Eric-2012/ESP32-CAN/PCB/ESP32-CAN/Pictures/ESP32-CAN2.png

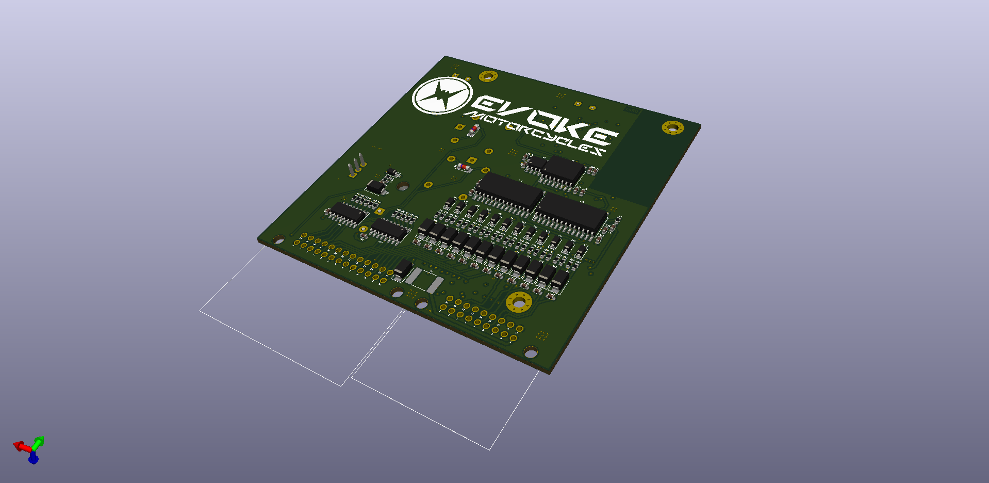
PCB/ESP32-CAN/Pictures/ESP32-CAN2.png
