Eric-2012/ESP32-CAN/PCB/ESP32-CAN/Pictures/ESP32-CAN - no bg.png

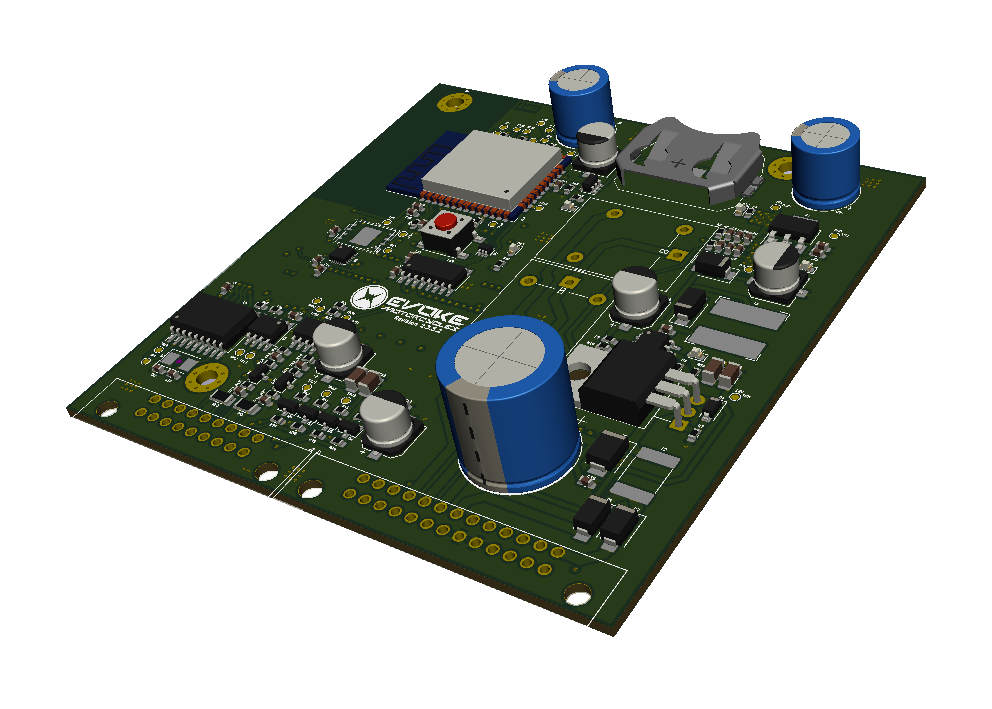
PCB/ESP32-CAN/Pictures/ESP32-CAN - no bg.png
