Eric-2012/ESP32-CAN/PCB/Production Files/Archived Nov 5, 2021/BOM ESP32-CAN Revision 3.3.3.xlsx

 | References | Value | Footprint | Quantity
1 | C5, C6, C64, C67, C68 | 100uF/25V | CP_Elec_6.3x5.8 | 5
2 | C54, C55 | 1500uf/16V | CP_Radial_D10.0mm_P5.00mm | 2
3 | C1 | 4700uF/25V | CP_Radial_D16.0mm_P7.50mm | 1
4 | C7, C9, C10, C15, C16, C17, C18, C19, C20, C21, C24, C25, C26, C27, C29, C30, C31, C34, C35, C36, C38, C39, C40, C43, C45, C46, C47, C48, C49, C50, C51, C52, C53, C58, C60, C61 | 100nF | C_0603_1608Metric | 36
5 | C8, C22, C23, C28, C32, C33, C44, C56, C57, C59, C62 | 10uF | C_0603_1608Metric | 11
6 | C13, C14, C41, C42 | 560pF | C_0603_1608Metric | 4
7 | C11, C12 | 22pF | C_0603_1608Metric | 2
8 | C4 | 10nF | C_0603_1608Metric | 1
9 | C2, C3 | 4.7uF | C_1206_3216Metric | 2
10 | C65, C66 | 10uf | C_1206_3216Metric | 2
11 | R4, R11, R24, R25, R26, R29, R47, R48, R49, R50, R51, R52, R53, R54, R55, R56, R57, R59, R73, R80, R81, R82, R83, R84, R85, R92 | 1.3kΩ | R_0603_1608Metric | 26
12 | R2, R8, R9, R18, R30, R38, R39, R41, R42, R43, R44, R45, R46, R60, R68, R71, R93 | 10KΩ | R_0603_1608Metric | 17
13 | R1, R22, R23, R28, R31, R58, R72, R74, R75, R76, R77, R78, R79 | 5.1KΩ | R_0603_1608Metric | 13
14 | R3, R12, R19, R37, R40 | 4.7KΩ | R_0603_1608Metric | 5
15 | R13, R14, R20, R21 | 100Ω | R_0603_1608Metric | 4
16 | R61, R65 | 3K3Ω | R_0603_1608Metric | 2
17 | R67, R70 | 22KΩ | R_0603_1608Metric | 2
18 | R5 | 68KΩ | R_0603_1608Metric | 1
19 | R6 | 12KΩ | R_0603_1608Metric | 1
20 | R7 | 100KΩ | R_0603_1608Metric | 1
21 | R10 | 3.24KΩ | R_0603_1608Metric | 1
22 | R66 | 220kΩ | R_0603_1608Metric | 1
23 | R62, R63 | 120Ω | R_1206_3216Metric | 2
24 | L1 | SRN1060-330M | L_Bourns-SRN1060 | 1
25 | D20, D21 | 1N4148 | D_MiniMELF_POLARITY | 2
26 | D9, D10, D11, D13, D14, D23, D31, D33, D34, D35, D36, D37, D38 | SMAJ20A | D_SMA_POL | 13
27 | D1, D2, D6, D8 | B240A | D_SMA_POL | 4
28 | D5 | B340A | D_SMA_POL | 1
29 | D3 | SMBJ20A | D_SMB | 1
30 | D12, D15, D16, D24, D32, D39, D40, D41, D42, D43, D44, D48, D49 | MM1Z3V0 | D_SOD-123_POLARITY | 13
31 | D4 | 9.1V | D_SOD-123_POLARITY | 1
32 | D17, D27, D28, D30, D46 | LED | LED_0603_1608Metric_POLARITY | 5
33 | D7, D22 | PESD1CAN | SOT-23 | 2
34 | U13 | ESP32-WROOM-32D | ESP32-WROOM-32 | 1
35 | U6 | MPU-9250 | QFN-24-1EP_3x3mm_P0.4mm_EP1.75x1.6mm | 1
36 | U9 | DS3231M | SOIC-16W_7.5x10.3mm_P1.27mm | 1
37 | U16, U17 | ULN2003 | SOIC-16_3.9x9.9mm_P1.27mm | 2
38 | U12 | CH340C | SOIC-16_3.9x9.9mm_P1.27mm | 1
39 | U4 | MCP2515-xSO | SOIC-18W_7.5x11.6mm_P1.27mm | 1
40 | U15, U18 | MCP23017_SO | SOIC-28W_7.5x17.9mm_P1.27mm | 2
41 | U5, U10 | TJA1050 | SOIC-8_3.9x4.9mm_P1.27mm | 2
42 | U3 | TPS5420D | SOIC-8_3.9x4.9mm_P1.27mm | 1
43 | U8 | MB85RC256V | SOIC-8_3.9x4.9mm_P1.27mm | 1
44 | U1 | LM1117M-3.3 | SOT-223-3_TabPin2 | 1
45 | Y1 | 8MHz | Crystal_SMD_5032-2Pin_5.0x3.2mm | 1
46 | F1, F2 | 0ZCF0100AF2A | Fuse_2920_7451Metric | 2
47 | SW1 | RESET | SW_SPST_PTS645 | 1
48 | BT1 | Battery_Cell | BatteryHolder_Keystone_3034_1x20mm | 1
49 |  |  | EvokeLogoName | 1
50 |  |  | EvokeLogoName3 | 1
51 | K1, K2 | G5LE-1 | Relay_SPDT_Omron-G5LE-1 | 2
52 | IC1 | W25M512JVEIQ | SON127P800X600X80-9N-D | 1
53 | Q2, Q3, Q4, Q5 | BSS138 | SOT-23 | 4
54 | IC2 | LTC4054 | SOT-23-5 | 1
55 | Q6 | UMH3N | SOT-363_SC-70-6 | 1
56 | Q1 | IRF9540N | TO-220-3_Horizontal_TabDown | 1
57 | J2 | 2x9_pin_Connector | 3118A0312 | 1
58 | J1 | 2x13_pin_Connector | 3126A0312 | 1
