Eric-2012/ESP32-CAN/PCB/ESP32-CAN.pdf

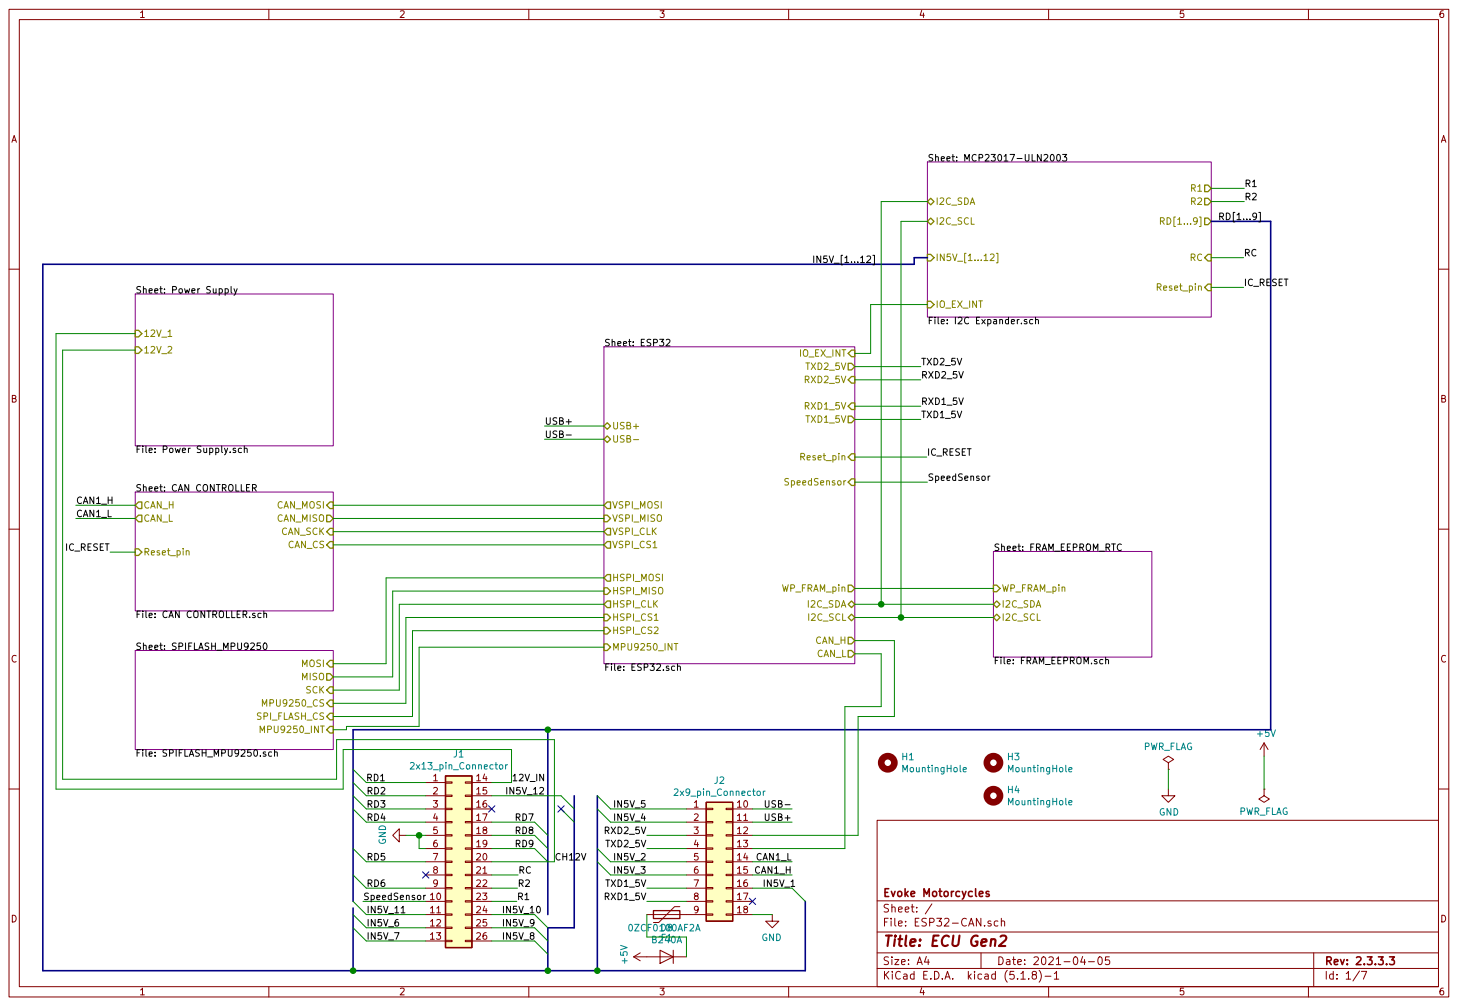
[picture p4: page 1]

Sheet: MCP23017-ULN2003 File: I2C Expander.sch

USB- USB+ USB- USB+ RD7

File: Power Supply.sch

File: ESP32-CAN.sch Sheet: / Evoke Motorcycles Sheet: CAN CONTROLLER
File: CAN CONTROLLER.sch CAN_H

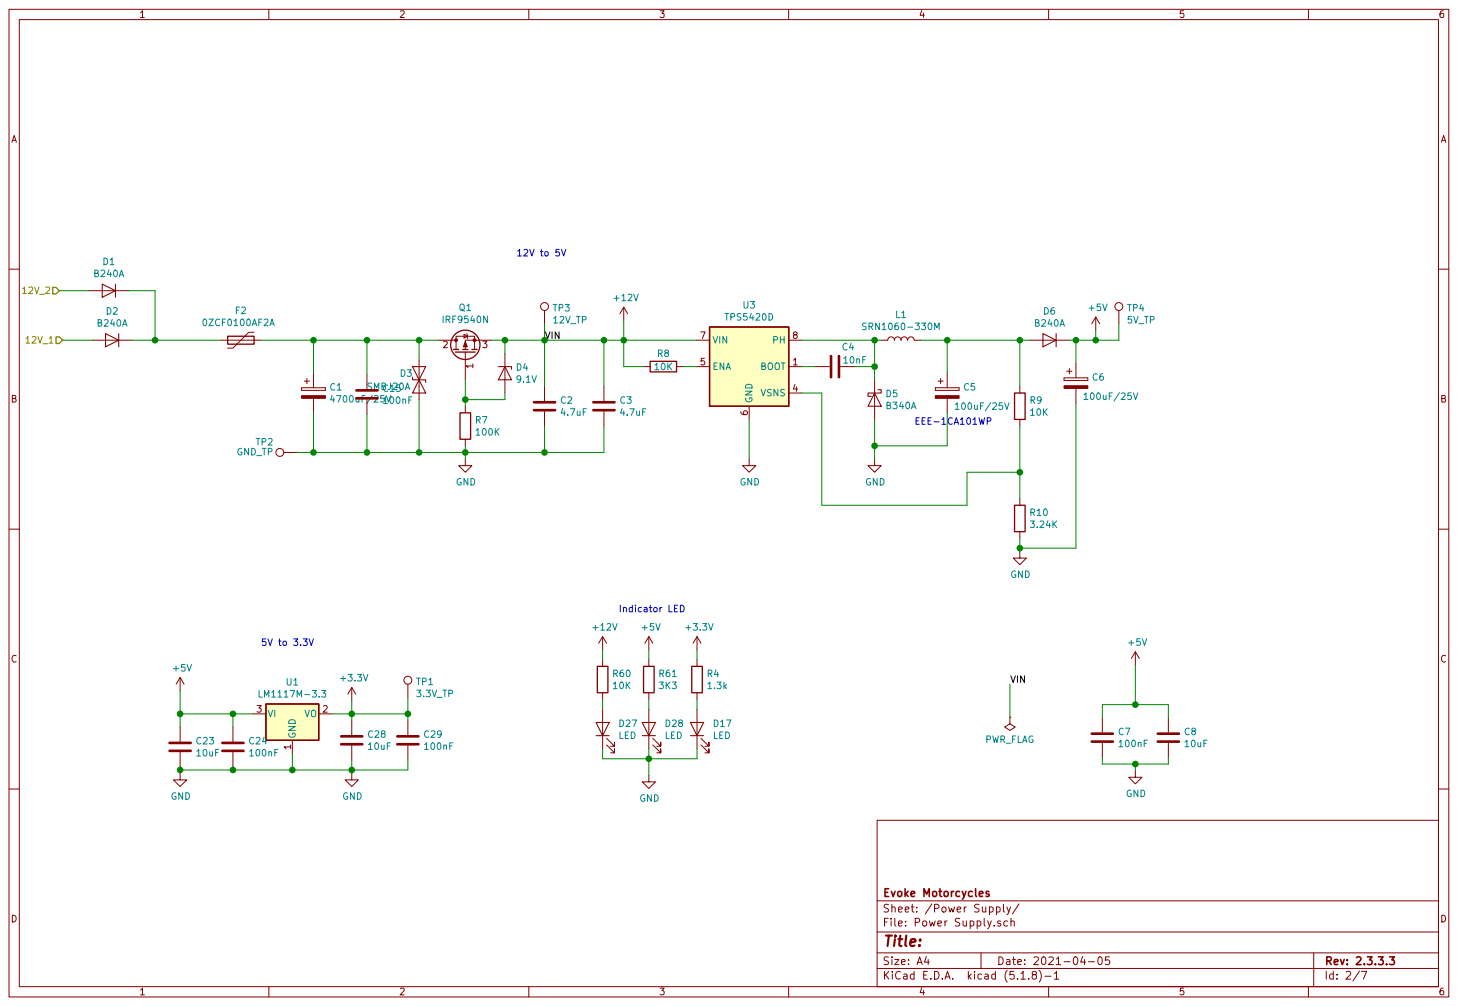
[picture p5: page 2]

Evoke Motorcycles
Sheet: /Power Supply/
File: Power Supply.sch
Id: 2/7 Title:

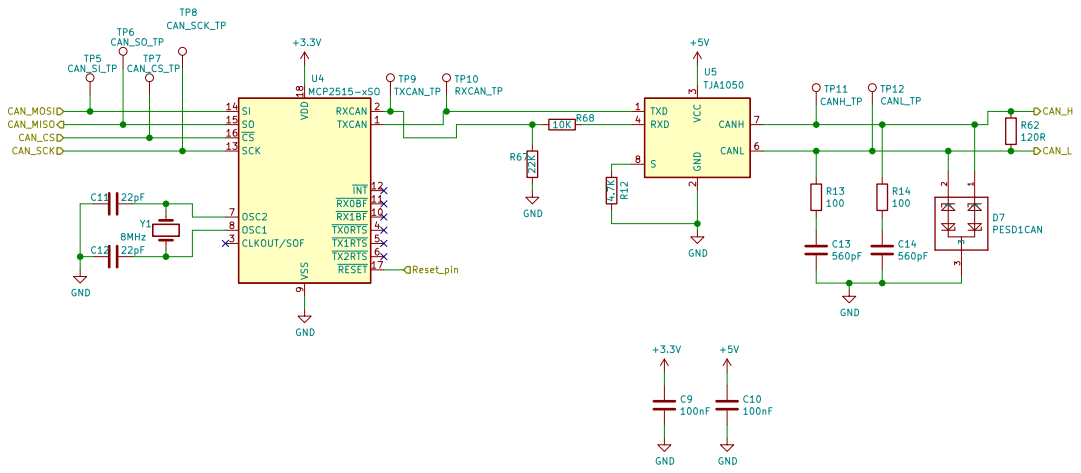
[picture p6: page 3]

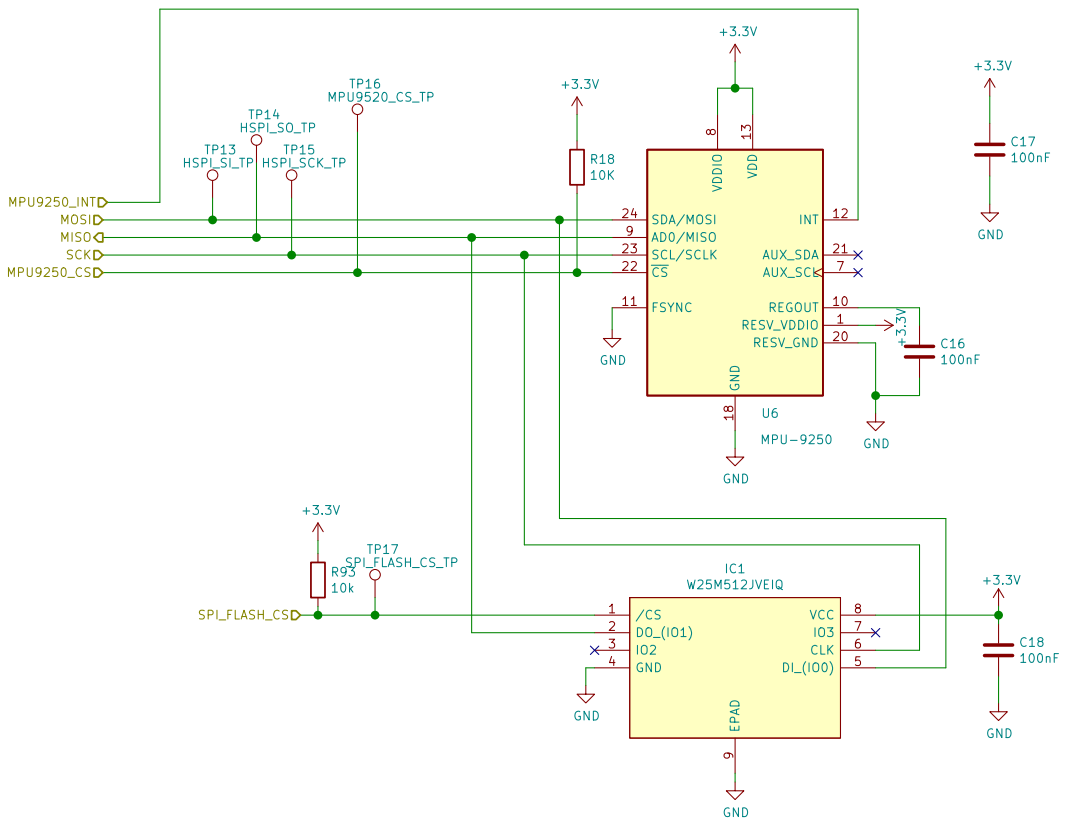
[picture p7: page 4]

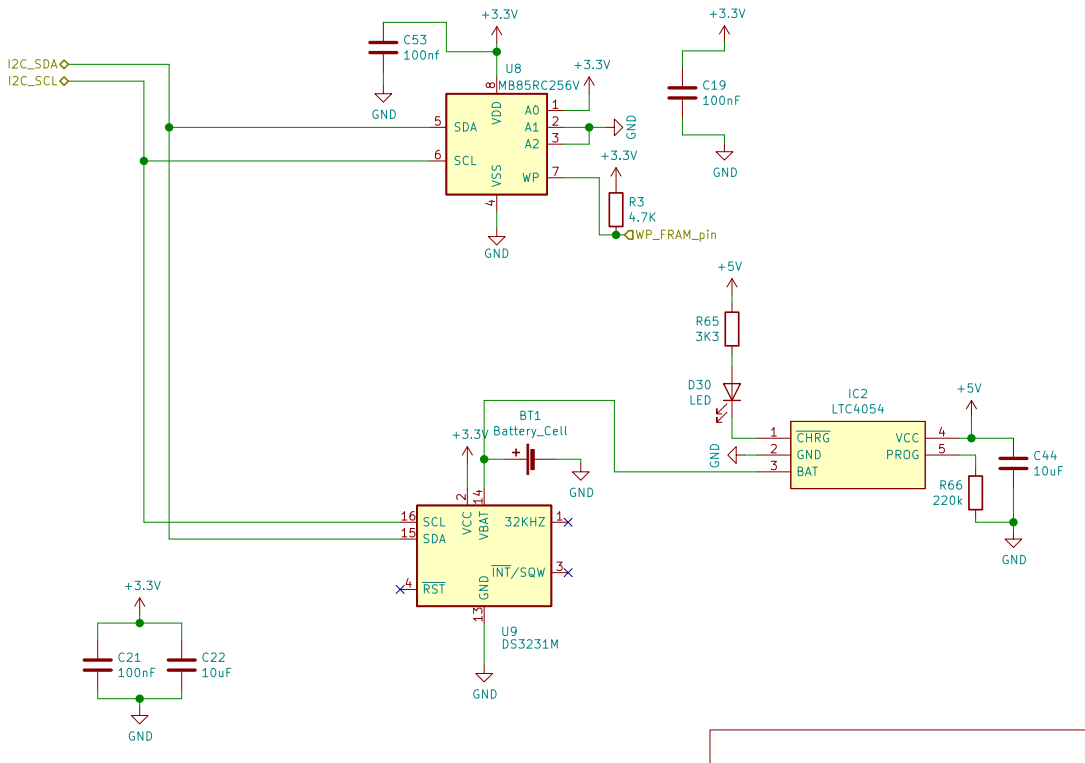
[picture p8: page 5]

4 SDA 5 SCL 6 WP 7 VDD

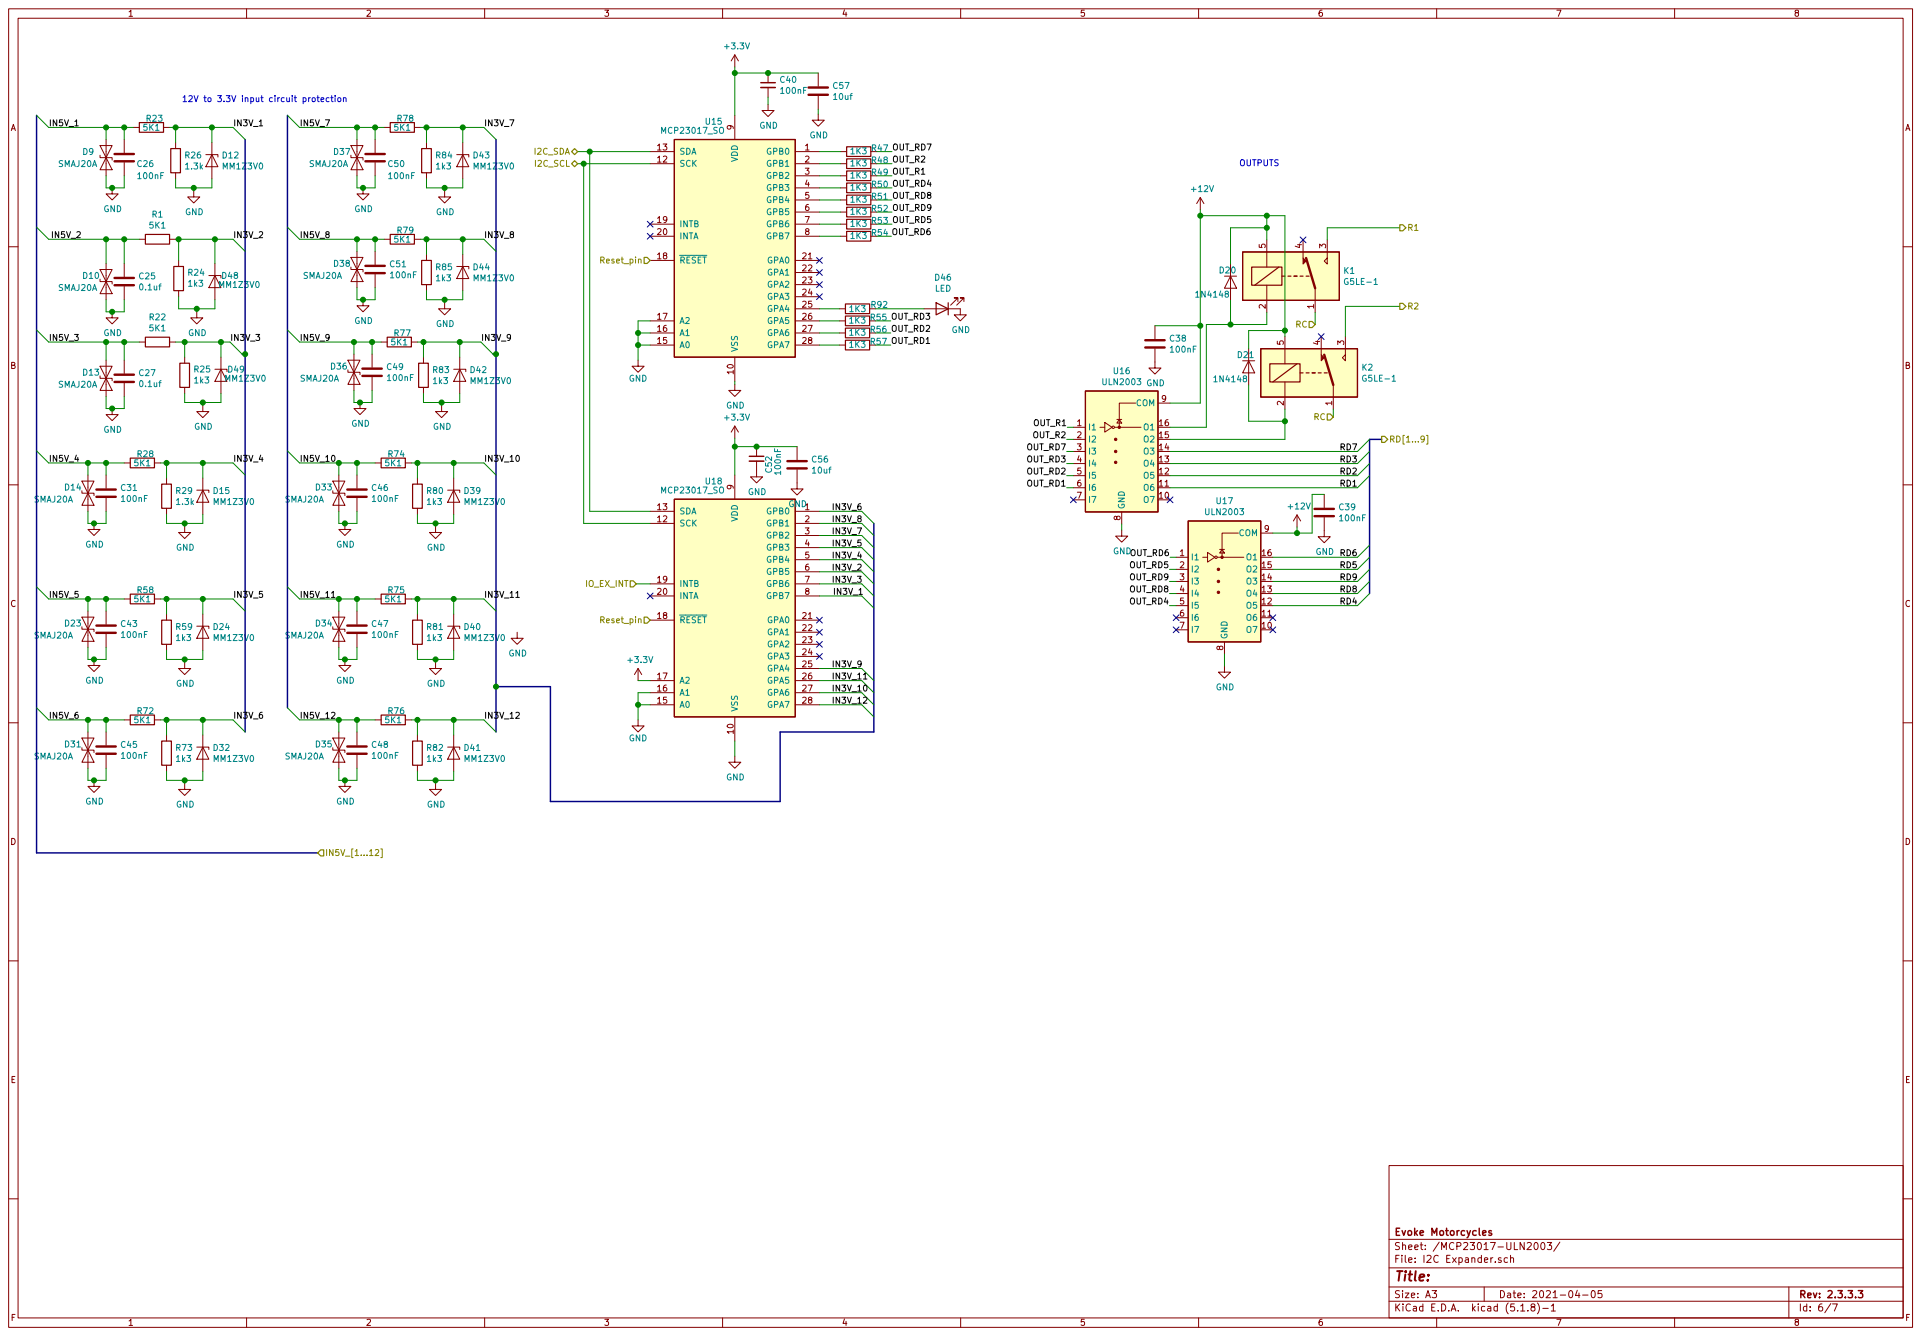
[picture p9: page 6]

12V to 3.3V input circuit protection

File: I2C Expander.sch Sheet: /MCP23017-ULN2003/ Evoke Motorcycles

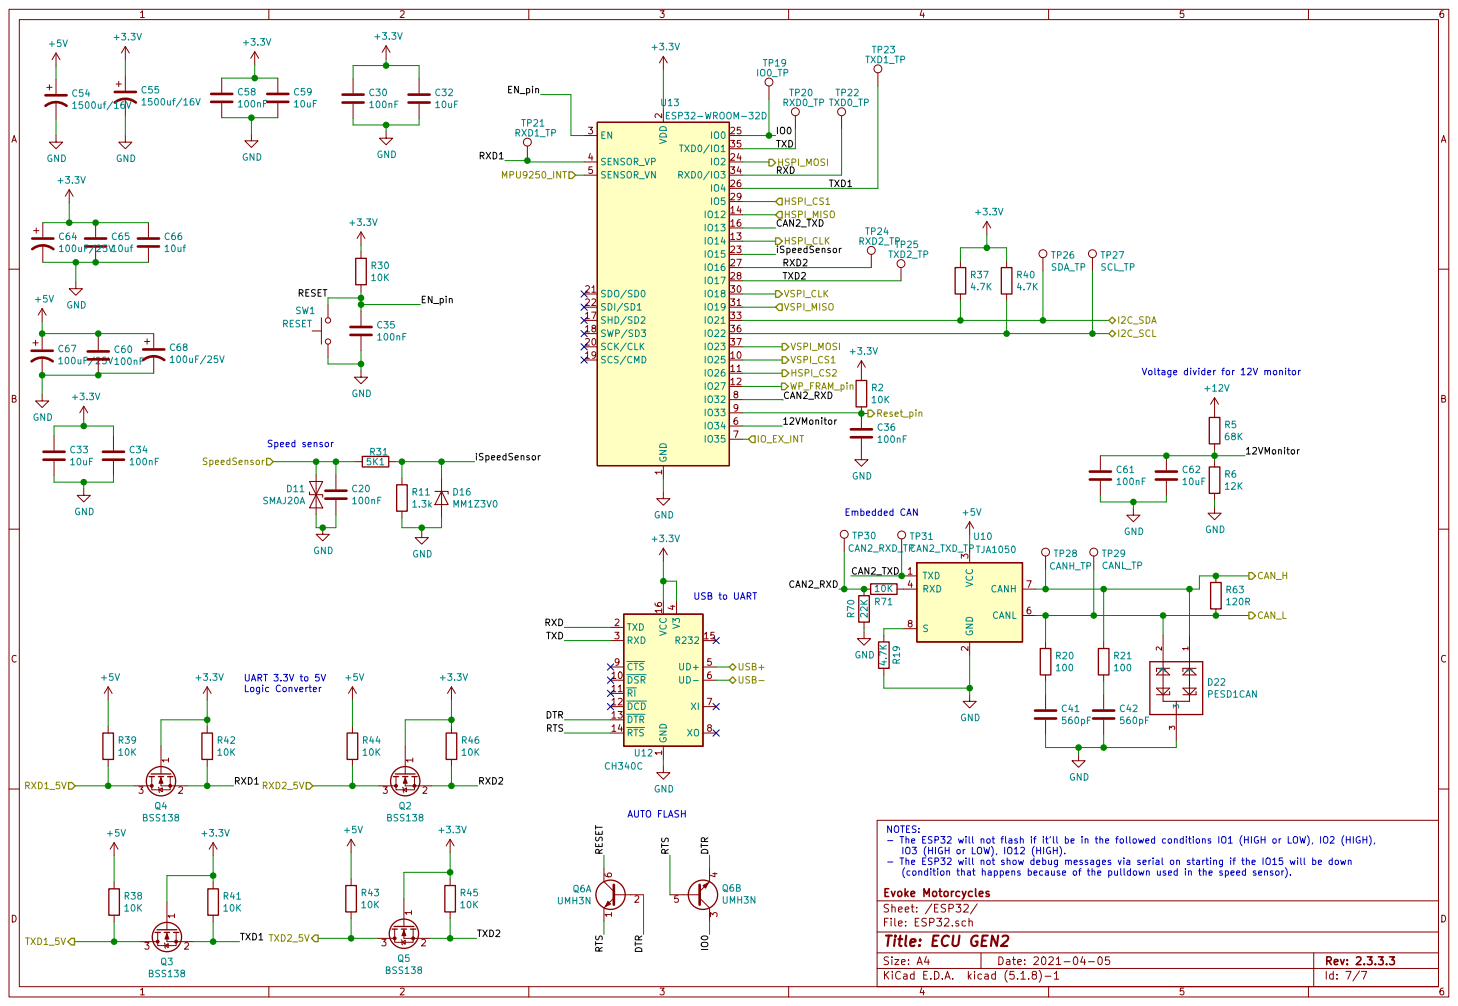
[picture p10: page 7]

2 SCK/CLK 20 SDO/SD0 21 SDI/SD1 22

Voltage divider for 12V monitor Embedded CAN

4 UD+ 5 UD- 6 XI 7 XO 8 CTS 9 U12 CH340C

1 DSR 10 RI 11 DCD 12 DTR 13 RTS 14 R232 VCC 15 16 TXD 2 RXD 3 V3

(condition that happens because of the pulldown used in the speed sensor). UART 3.3V to 5V
Logic Converter

IO3 (HIGH or LOW), IO12 (HIGH).
- The ESP32 will not show debug messages via serial on starting if the IO15 will be down

File: ESP32.sch Sheet: /ESP32/ Evoke Motorcycles
