Eric-2012/ESP32-CAN/PCB/ESP32-CAN/ESP32-CAN.kicad_pcb

## KiCad design PCB/ESP32-CAN/ESP32-CAN.kicad_pcb (2023-08-11)

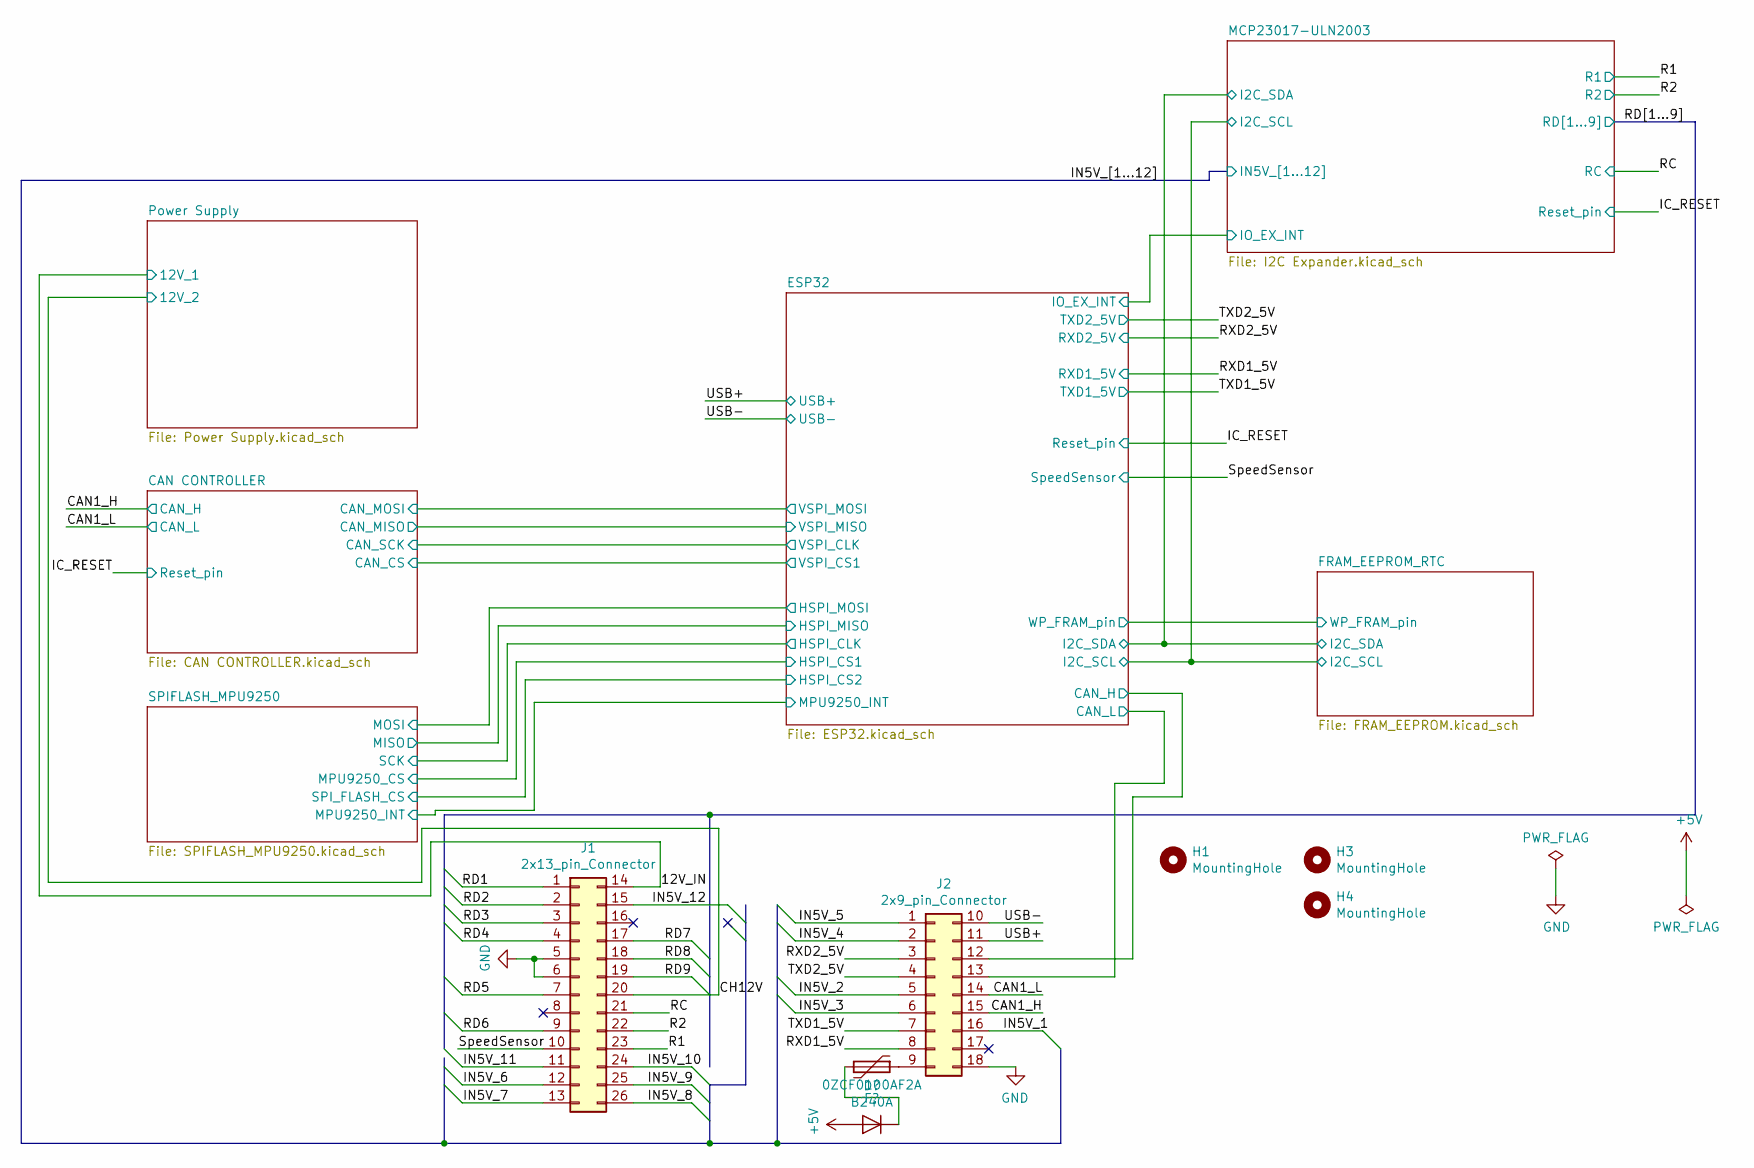
[picture p11: schematic ESP32-CAN.kicad_sch, ECU Gen2]

Parts:
D8: B240A; D_SMA
F1: 0ZCF0100AF2A; Fuse_2920_7451Metric
H1, H3, H4: MountingHole; MountingHole_3.2mm_M3_Pad_Via
J1: 2x13_pin_Connector; 3126A0312
J2: 2x9_pin_Connector; 3118A0312

Connections:
+5V: D8.2 (A); also elsewhere on the board
/12V_IN: J1.14; also elsewhere on the board
/CAN1_H: J2.15; also elsewhere on the board
/CAN1_L: J2.14; also elsewhere on the board
/CH12V: J1.20; also elsewhere on the board
/ESP32/CAN_H: J2.12; also elsewhere on the board
/ESP32/CAN_L: J2.13; also elsewhere on the board
/IN5V_1: J2.16; also elsewhere on the board
/IN5V_2: J2.5; also elsewhere on the board
/IN5V_3: J2.6; also elsewhere on the board
/IN5V_4: J2.2; also elsewhere on the board
/IN5V_5: J2.1; also elsewhere on the board
/IN5V_6: J1.12; also elsewhere on the board
/IN5V_7: J1.13; also elsewhere on the board
/IN5V_8: J1.26; also elsewhere on the board
/IN5V_9: J1.25; also elsewhere on the board
/IN5V_10: J1.24; also elsewhere on the board
/IN5V_11: J1.11; also elsewhere on the board
/IN5V_12: J1.15; also elsewhere on the board
/R1: J1.23; also elsewhere on the board
/R2: J1.22; also elsewhere on the board
/RC: J1.21; also elsewhere on the board
/RD1: J1.1; also elsewhere on the board
/RD2: J1.2; also elsewhere on the board
/RD3: J1.3; also elsewhere on the board
/RD4: J1.4; also elsewhere on the board
/RD5: J1.7; also elsewhere on the board
/RD6: J1.9; also elsewhere on the board
/RD7: J1.17; also elsewhere on the board
/RD8: J1.18; also elsewhere on the board
/RD9: J1.19; also elsewhere on the board
/RXD1_5V: J2.8; also elsewhere on the board
/RXD2_5V: J2.3; also elsewhere on the board
/SpeedSensor: J1.10; also elsewhere on the board
/TXD1_5V: J2.7; also elsewhere on the board
/TXD2_5V: J2.4; also elsewhere on the board
/USB+: J2.11; also elsewhere on the board
/USB-: J2.10; also elsewhere on the board
GND: J1.5, J1.6, J2.18; also elsewhere on the board
unnamed: D8.1 (K), F1.2
unnamed: F1.1, J2.9

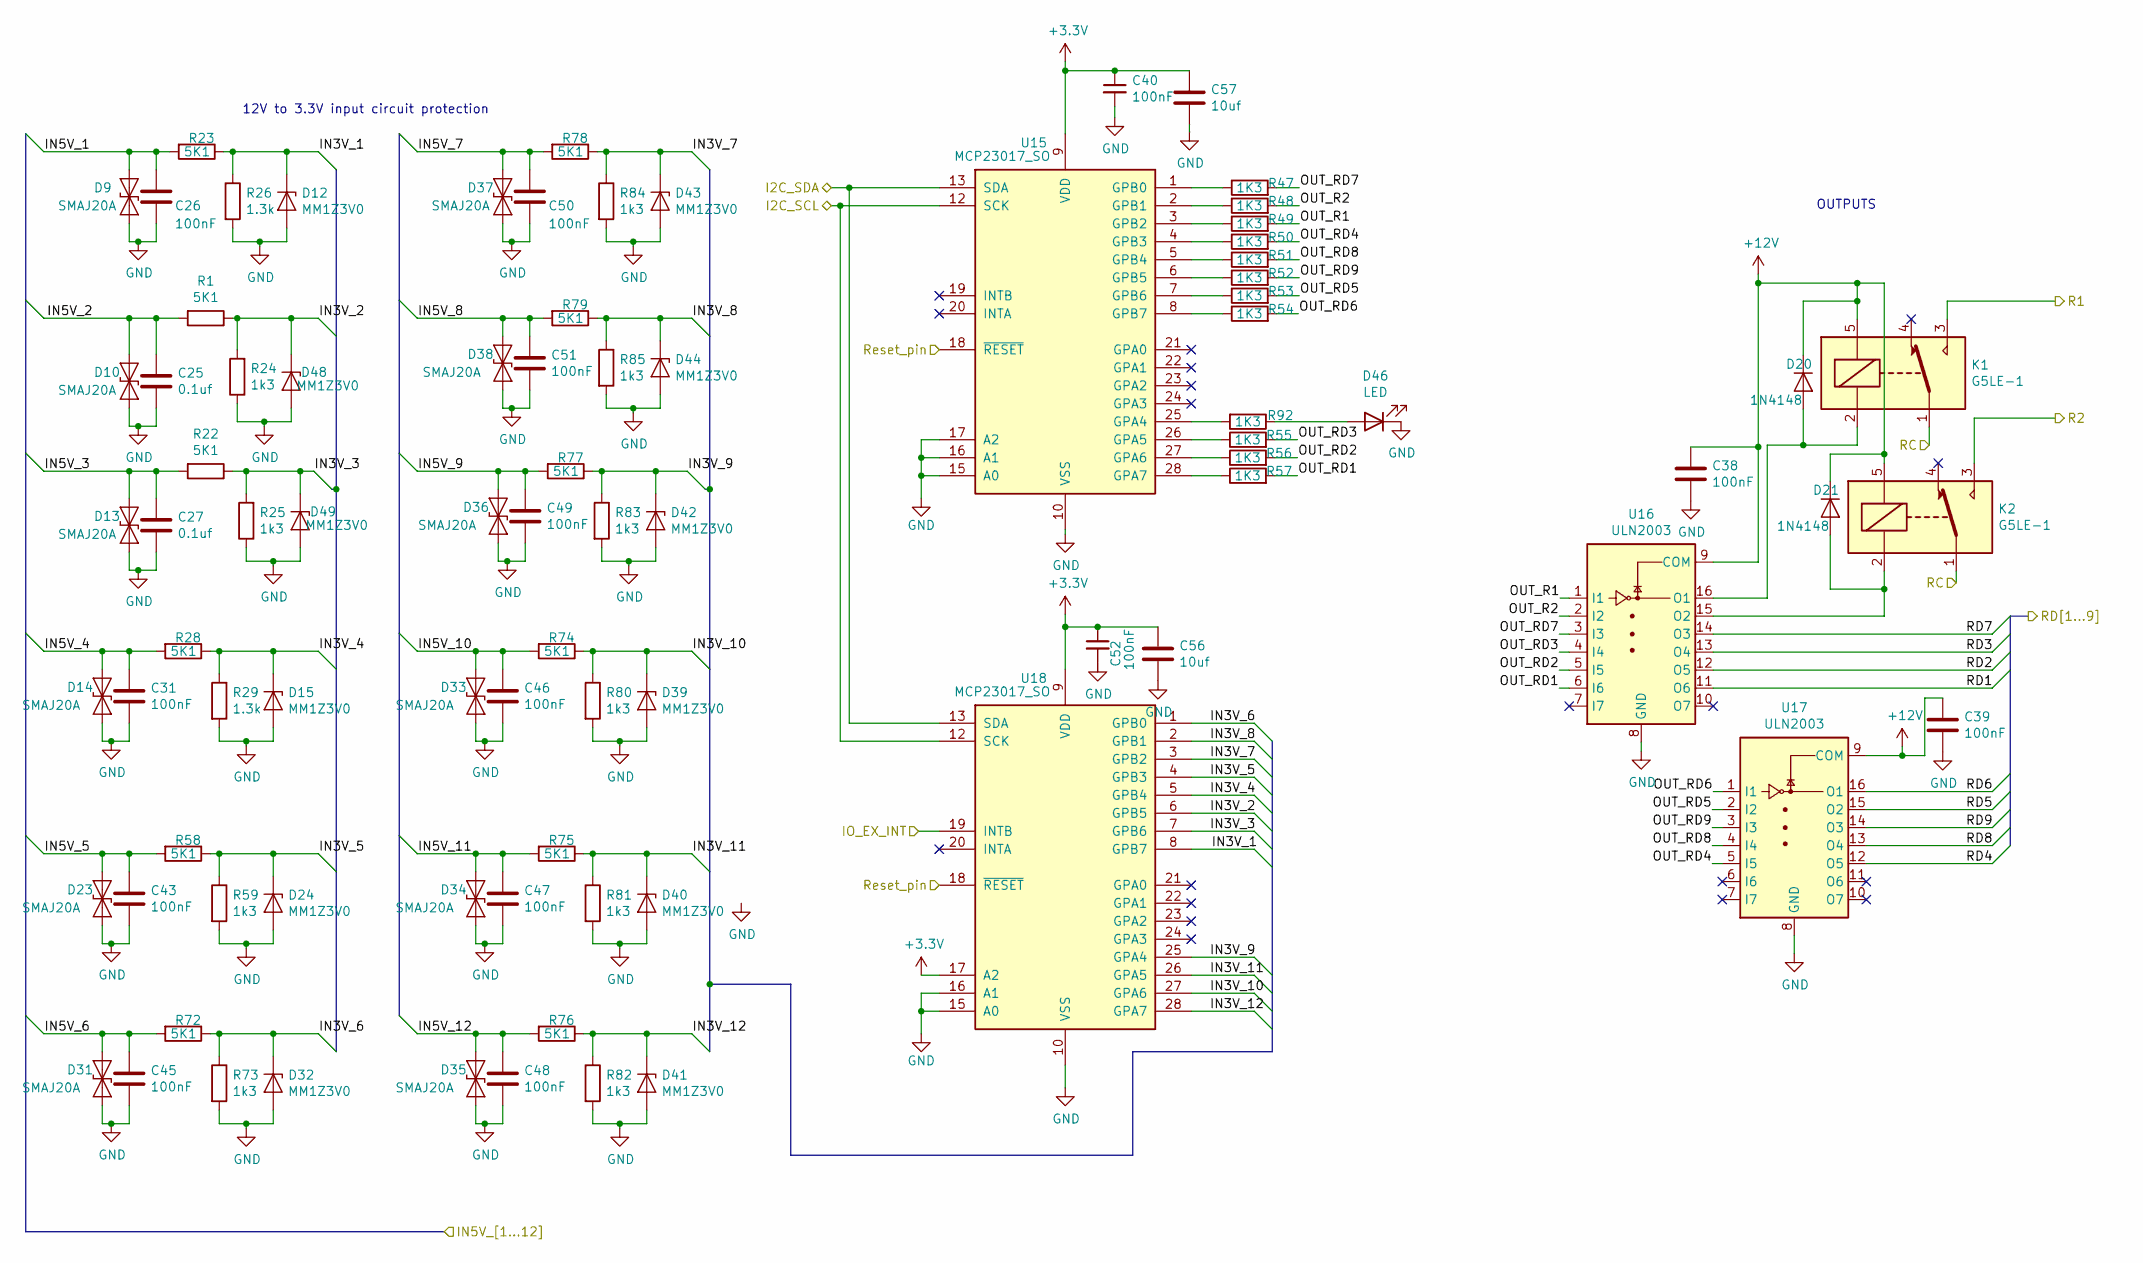
[picture p12: schematic I2C Expander.kicad_sch]

Parts:
C25, C27: 0.1uf; C_0603_1608Metric
C26, C31, C38, C39, C40, C43, C45, C46, C47, C48, C49, C50, C51, C52: 100nF; C_0603_1608Metric
C56, C57: 10uf; C_0603_1608Metric
D9, D10, D13, D14, D23, D31, D33, D34, D35, D36, D37, D38: SMAJ20A; D_SMA
D12, D15, D24, D32, D39, D40, D41, D42, D43, D44, D48, D49: MM1Z3V0; D_SOD-123
D20, D21: 1N4148; D_MiniMELF
D46: LED; LED_0603_1608Metric
K1, K2: G5LE-1; Relay_SPDT_Omron-G5LE-1
R1, R22, R23, R28, R58, R72, R74, R75, R76, R77, R78, R79: 5K1; R_0603_1608Metric
R24, R25, R59, R73, R80, R81, R82, R83, R84, R85: 1k3; R_0603_1608Metric
R26, R29: 1.3k; R_0603_1608Metric
R47, R48, R49, R50, R51, R52, R53, R54, R55, R56, R57, R92: 1K3; R_0603_1608Metric
U15, U18: MCP23017_SO; SOIC-28W_7.5x17.9mm_P1.27mm
U16, U17: ULN2003; SOIC-16_3.9x9.9mm_P1.27mm

Connections:
+3V3: C40.1, C52.1, C56.1, C57.1, U15.9 (VDD), U18.9 (VDD), U18.17 (A2); also elsewhere on the board
+12V: C38.1, C39.1, D20.1 (K), D21.1 (K), K1.5, K2.5, U16.9 (COM), U17.9 (COM); also elsewhere on the board
/ESP32/I2C_SCL: U15.12 (SCK), U18.12 (SCK); also elsewhere on the board
/ESP32/I2C_SDA: U15.13 (SDA), U18.13 (SDA); also elsewhere on the board
/ESP32/IO_EX_INT: U18.19 (INTB); also elsewhere on the board
/IC_RESET: U15.18 (~RESET), U18.18 (~RESET); also elsewhere on the board
/IN5V_1: C26.1, D9.1 (A1), R23.2; also elsewhere on the board
/IN5V_2: C25.1, D10.1 (A1), R1.2; also elsewhere on the board
/IN5V_3: C27.1, D13.1 (A1), R22.2; also elsewhere on the board
/IN5V_4: C31.1, D14.1 (A1), R28.2; also elsewhere on the board
/IN5V_5: C43.1, D23.1 (A1), R58.2; also elsewhere on the board
/IN5V_6: C45.1, D31.1 (A1), R72.2; also elsewhere on the board
/IN5V_7: C50.1, D37.1 (A1), R78.2; also elsewhere on the board
/IN5V_8: C51.1, D38.1 (A1), R79.2; also elsewhere on the board
/IN5V_9: C49.1, D36.1 (A1), R77.2; also elsewhere on the board
/IN5V_10: C46.1, D33.1 (A1), R74.2; also elsewhere on the board
/IN5V_11: C47.1, D34.1 (A1), R75.2; also elsewhere on the board
/IN5V_12: C48.1, D35.1 (A1), R76.2; also elsewhere on the board
/MCP23017-ULN2003/IN3V_1: D12.1 (K), R23.1, R26.1, U18.8 (GPB7)
/MCP23017-ULN2003/IN3V_2: D48.1 (K), R1.1, R24.2, U18.6 (GPB5)
/MCP23017-ULN2003/IN3V_3: D49.1 (K), R22.1, R25.2, U18.7 (GPB6)
/MCP23017-ULN2003/IN3V_4: D15.1 (K), R28.1, R29.1, U18.5 (GPB4)
/MCP23017-ULN2003/IN3V_5: D24.1 (K), R58.1, R59.1, U18.4 (GPB3)
/MCP23017-ULN2003/IN3V_6: D32.1 (K), R72.1, R73.1, U18.1 (GPB0)
/MCP23017-ULN2003/IN3V_7: D43.1 (K), R78.1, R84.1, U18.3 (GPB2)
/MCP23017-ULN2003/IN3V_8: D44.1 (K), R79.1, R85.1, U18.2 (GPB1)
/MCP23017-ULN2003/IN3V_9: D42.1 (K), R77.1, R83.1, U18.25 (GPA4)
/MCP23017-ULN2003/IN3V_10: D39.1 (K), R74.1, R80.1, U18.27 (GPA6)
/MCP23017-ULN2003/IN3V_11: D40.1 (K), R75.1, R81.1, U18.26 (GPA5)
/MCP23017-ULN2003/IN3V_12: D41.1 (K), R76.1, R82.1, U18.28 (GPA7)
/MCP23017-ULN2003/OUT_R1: R49.2, U16.1 (I1)
/MCP23017-ULN2003/OUT_R2: R48.2, U16.2 (I2)
/MCP23017-ULN2003/OUT_RD1: R57.2, U16.6 (I6)
/MCP23017-ULN2003/OUT_RD2: R56.2, U16.5 (I5)
/MCP23017-ULN2003/OUT_RD3: R55.2, U16.4 (I4)
/MCP23017-ULN2003/OUT_RD4: R50.2, U17.5 (I5)
/MCP23017-ULN2003/OUT_RD5: R53.2, U17.2 (I2)
/MCP23017-ULN2003/OUT_RD6: R54.2, U17.1 (I1)
/MCP23017-ULN2003/OUT_RD7: R47.2, U16.3 (I3)
/MCP23017-ULN2003/OUT_RD8: R51.2, U17.4 (I4)
/MCP23017-ULN2003/OUT_RD9: R52.2, U17.3 (I3)
/R1: K1.3; also elsewhere on the board
/R2: K2.3; also elsewhere on the board
/RC: K1.1, K2.1; also elsewhere on the board
/RD1: U16.11 (O6); also elsewhere on the board
/RD2: U16.12 (O5); also elsewhere on the board
/RD3: U16.13 (O4); also elsewhere on the board
/RD4: U17.12 (O5); also elsewhere on the board
/RD5: U17.15 (O2); also elsewhere on the board
/RD6: U17.16 (O1); also elsewhere on the board
/RD7: U16.14 (O3); also elsewhere on the board
/RD8: U17.13 (O4); also elsewhere on the board
/RD9: U17.14 (O3); also elsewhere on the board
GND: C25.2, C26.2, C27.2, C31.2, C38.2, C39.2, C40.2, C43.2, C45.2, C46.2, C47.2, C48.2, C49.2, C50.2, C51.2, C52.2, C56.2, C57.2, D9.2 (A2), D10.2 (A2), D12.2 (A), D13.2 (A2), D14.2 (A2), D15.2 (A), D23.2 (A2), D24.2 (A), D31.2 (A2), D32.2 (A), D33.2 (A2), D34.2 (A2), D35.2 (A2), D36.2 (A2), D37.2 (A2), D38.2 (A2), D39.2 (A), D40.2 (A), D41.2 (A), D42.2 (A), D43.2 (A), D44.2 (A), D46.1 (K), D48.2 (A), D49.2 (A), R24.1, R25.1, R26.2, R29.2, R59.2, R73.2, R80.2, R81.2, R82.2, R83.2, R84.2, R85.2, U15.10 (VSS), U15.15 (A0), U15.16 (A1), U15.17 (A2), U16.8 (GND), U17.8 (GND), U18.10 (VSS), U18.15 (A0), U18.16 (A1); also elsewhere on the board
unnamed: D20.2 (A), K1.2, U16.16 (O1)
unnamed: D21.2 (A), K2.2, U16.15 (O2)
unnamed: D46.2 (A), R92.1
unnamed: R47.1, U15.1 (GPB0)
unnamed: R48.1, U15.2 (GPB1)
unnamed: R49.1, U15.3 (GPB2)
unnamed: R50.1, U15.4 (GPB3)
unnamed: R51.1, U15.5 (GPB4)
unnamed: R52.1, U15.6 (GPB5)
unnamed: R53.1, U15.7 (GPB6)
unnamed: R54.1, U15.8 (GPB7)
unnamed: R55.1, U15.26 (GPA5)
unnamed: R56.1, U15.27 (GPA6)
unnamed: R57.1, U15.28 (GPA7)
unnamed: R92.2, U15.25 (GPA4)

Notes on the sheet:
OUTPUTS
12V to 3.3V input circuit protection

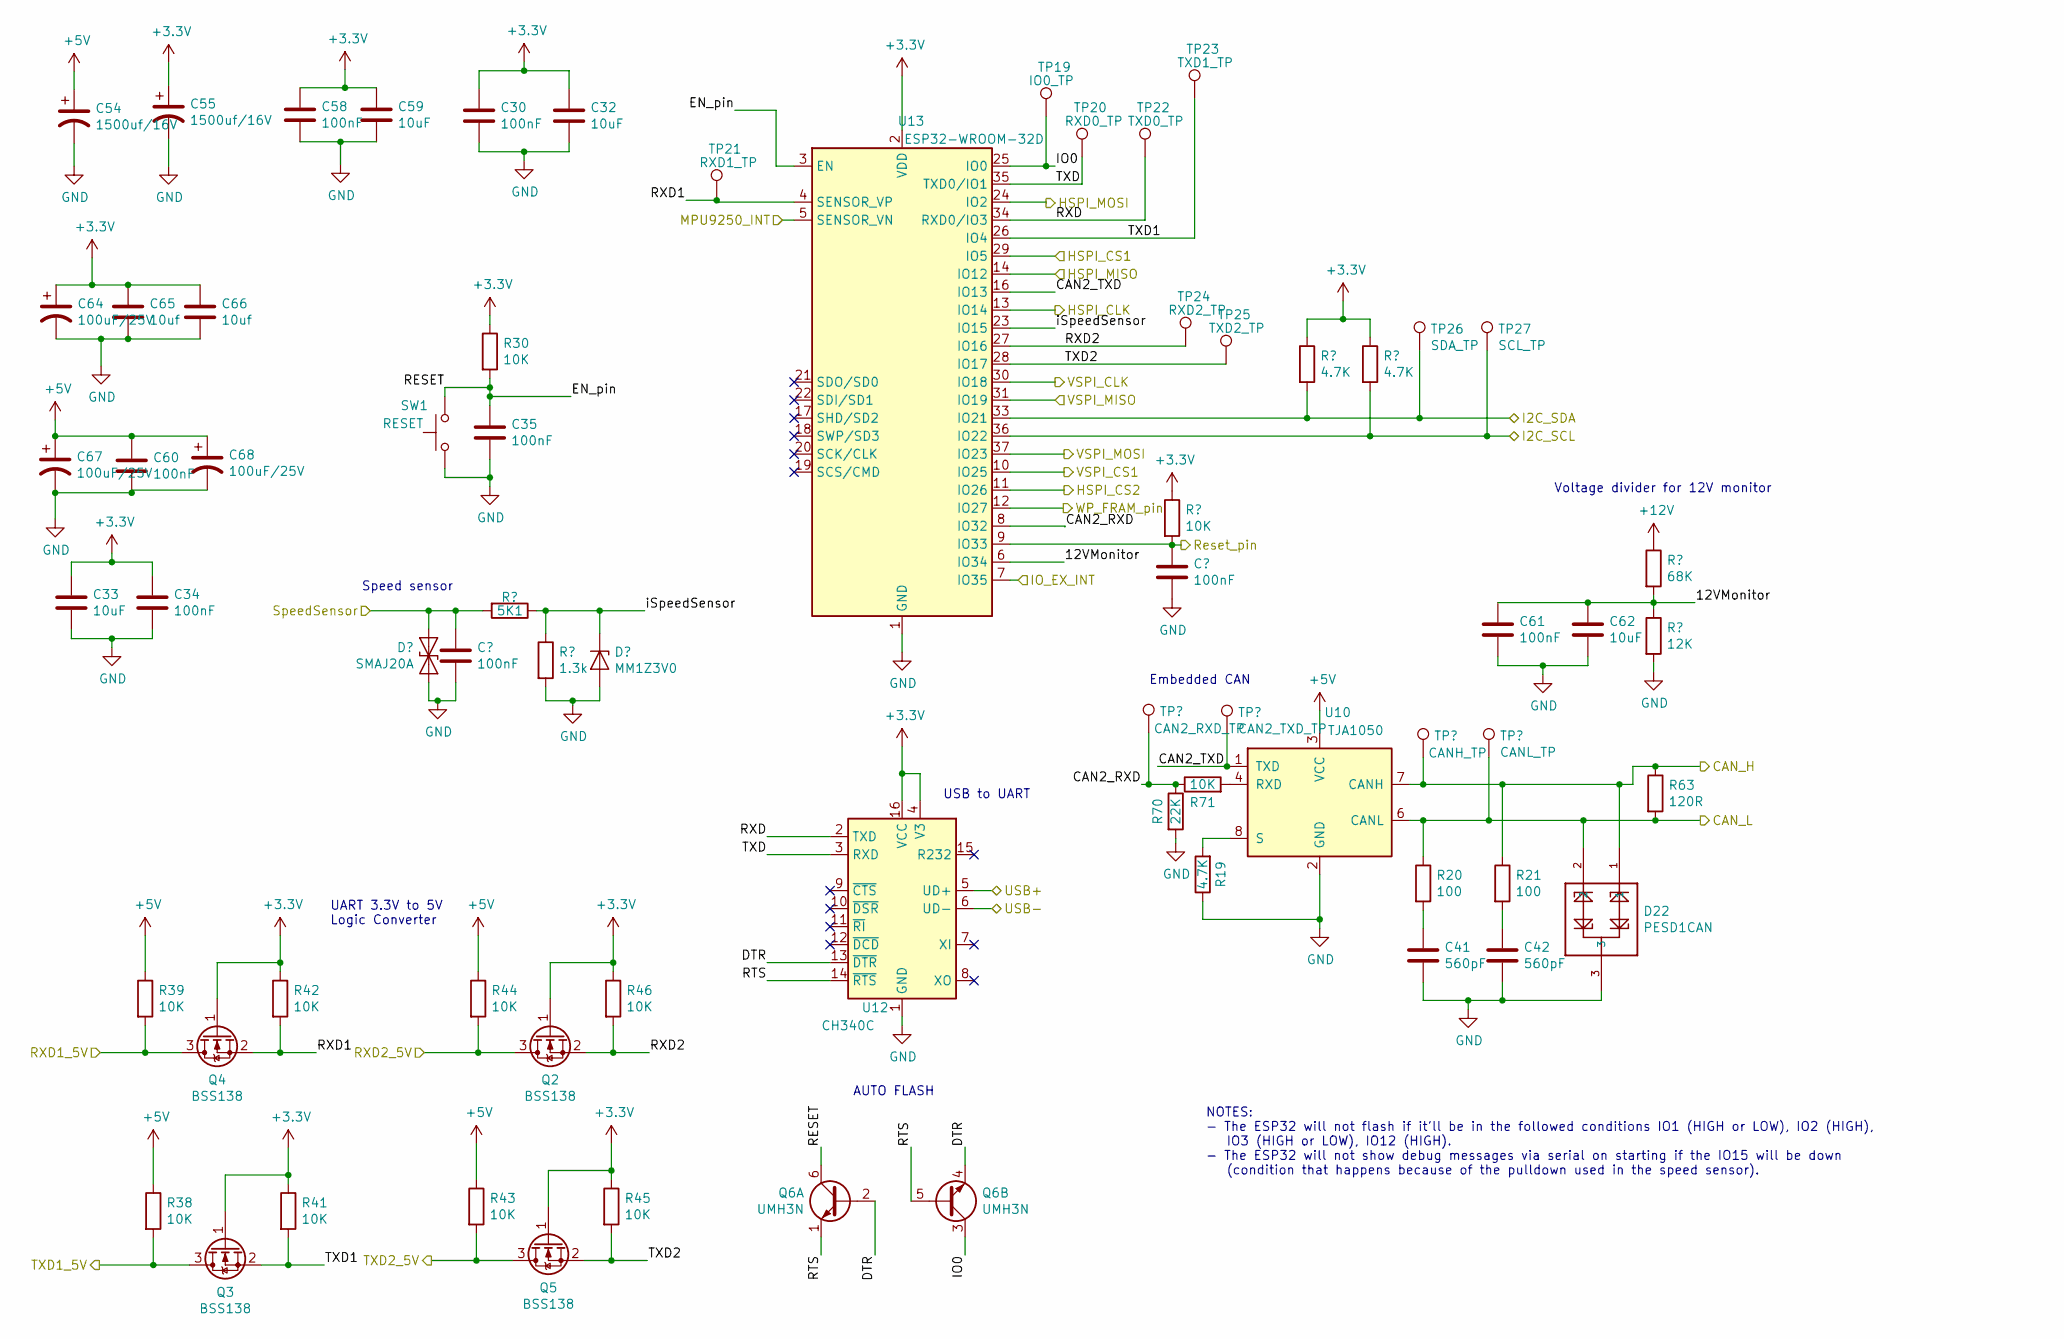
[picture p13: schematic ESP32.kicad_sch, ECU GEN2]

Parts:
C20, C30, C34, C35, C36, C58, C60, C61: 100nF; C_0603_1608Metric
C32, C33, C59, C62: 10uF; C_0603_1608Metric
C41, C42: 560pF; C_0603_1608Metric
C54, C55: 1500uf/16V; CP_Radial_D10.0mm_P5.00mm
C64, C67, C68: 100uF/25V; CP_Elec_6.3x5.8
C65, C66: 10uf; C_1206_3216Metric
D11: SMAJ20A; D_SMA
D16: MM1Z3V0; D_SOD-123
D22: PESD1CAN; SOT-23
Q2, Q3, Q4, Q5: BSS138; SOT-23
Q6: UMH3N; SOT-363_SC-70-6
R2, R30, R38, R39, R41, R42, R43, R44, R45, R46, R71: 10K; R_0603_1608Metric
R5: 68K; R_0603_1608Metric; Tolerance 1%
R6: 12K; R_0603_1608Metric; Tolerance 1%
R11: 1.3k; R_0603_1608Metric
R19, R37, R40: 4.7K; R_0603_1608Metric
R20, R21: 100; R_0603_1608Metric
R31: 5K1; R_0603_1608Metric
R63: 120R; R_1206_3216Metric
R70: 22K; R_0603_1608Metric
SW1: RESET; SW_SPST_PTS645
TP19: IO0_TP; TestPoint_Pad_D1.0mm
TP20: RXD0_TP; TestPoint_Pad_D1.0mm
TP21: RXD1_TP; TestPoint_Pad_D1.0mm
TP22: TXD0_TP; TestPoint_Pad_D1.0mm
TP23: TXD1_TP; TestPoint_Pad_D1.0mm
TP24: RXD2_TP; TestPoint_Pad_D1.0mm
TP25: TXD2_TP; TestPoint_Pad_D1.0mm
TP26: SDA_TP; TestPoint_Pad_D1.0mm
TP27: SCL_TP; TestPoint_Pad_D1.0mm
TP28: CANH_TP; TestPoint_Pad_D1.0mm
TP29: CANL_TP; TestPoint_Pad_D1.0mm
TP30: CAN2_RXD_TP; TestPoint_Pad_D1.0mm
TP31: CAN2_TXD_TP; TestPoint_Pad_D1.0mm
U10: TJA1050; SOIC-8_3.9x4.9mm_P1.27mm
U12: CH340C; SOIC-16_3.9x9.9mm_P1.27mm
U13: ESP32-WROOM-32D; ESP32-WROOM-32

Connections:
+3V3: C30.1, C32.1, C33.1, C34.1, C55.1, C58.1, C59.1, C64.1, C65.1, C66.1, Q2.1 (G), Q3.1 (G), Q4.1 (G), Q5.1 (G), R2.1, R30.1, R37.1, R40.1, R41.1, R42.1, R45.1, R46.1, U12.4 (V3), U12.16 (VCC), U13.2 (VDD); also elsewhere on the board
+5V: C54.1, C60.1, C67.1, C68.1, R38.1, R39.1, R43.1, R44.1, U10.3 (VCC); also elsewhere on the board
+12V: R5.1; also elsewhere on the board
/CAN CONTROLLER/CAN_CS: U13.10 (IO25); also elsewhere on the board
/CAN CONTROLLER/CAN_MISO: U13.31 (IO19); also elsewhere on the board
/CAN CONTROLLER/CAN_MOSI: U13.37 (IO23); also elsewhere on the board
/CAN CONTROLLER/CAN_SCK: U13.30 (IO18); also elsewhere on the board
/ESP32/12VMonitor: C61.1, C62.1, R5.2, R6.1, U13.6 (IO34)
/ESP32/CAN2_RXD: R70.1, R71.1, TP30.1, U13.8 (IO32)
/ESP32/CAN2_TXD: TP31.1, U10.1 (TXD), U13.16 (IO13)
/ESP32/CAN_H: D22.1, R21.1, R63.1, TP28.1, U10.7 (CANH); also elsewhere on the board
/ESP32/CAN_L: D22.2, R20.1, R63.2, TP29.1, U10.6 (CANL); also elsewhere on the board
/ESP32/DTR: Q6.2 (B1), Q6.4 (E2), U12.13 (~DTR)
/ESP32/EN_pin: C35.1, Q6.6 (C1), R30.2, SW1.2, U13.3 (EN)
/ESP32/HSPI_CLK: U13.13 (IO14); also elsewhere on the board
/ESP32/HSPI_CS1: U13.29 (IO5); also elsewhere on the board
/ESP32/HSPI_CS2: U13.11 (IO26); also elsewhere on the board
/ESP32/HSPI_MISO: U13.14 (IO12); also elsewhere on the board
/ESP32/HSPI_MOSI: U13.24 (IO2); also elsewhere on the board
/ESP32/I2C_SCL: R40.2, TP27.1, U13.36 (IO22); also elsewhere on the board
/ESP32/I2C_SDA: R37.2, TP26.1, U13.33 (IO21); also elsewhere on the board
/ESP32/IO0: Q6.3 (C2), TP19.1, U13.25 (IO0)
/ESP32/IO_EX_INT: U13.7 (IO35); also elsewhere on the board
/ESP32/MPU9250_INT: U13.5 (SENSOR_VN); also elsewhere on the board
/ESP32/RTS: Q6.1 (E1), Q6.5 (B2), U12.14 (~RTS)
/ESP32/RXD: TP22.1, U12.2 (TXD), U13.34 (RXD0/IO3)
/ESP32/RXD1: Q4.2 (S), R42.2, TP21.1, U13.4 (SENSOR_VP)
/ESP32/RXD2: Q2.2 (S), R46.2, TP24.1, U13.27 (IO16)
/ESP32/TXD: TP20.1, U12.3 (RXD), U13.35 (TXD0/IO1)
/ESP32/TXD1: Q3.2 (S), R41.2, TP23.1, U13.26 (IO4)
/ESP32/TXD2: Q5.2 (S), R45.2, TP25.1, U13.28 (IO17)
/ESP32/WP_FRAM_pin: U13.12 (IO27); also elsewhere on the board
/ESP32/iSpeedSensor: D16.1 (K), R11.1, R31.1, U13.23 (IO15)
/IC_RESET: C36.1, R2.2, U13.9 (IO33); also elsewhere on the board
/RXD1_5V: Q4.3 (D), R39.2; also elsewhere on the board
/RXD2_5V: Q2.3 (D), R44.2; also elsewhere on the board
/SpeedSensor: C20.1, D11.1 (A1), R31.2; also elsewhere on the board
/TXD1_5V: Q3.3 (D), R38.2; also elsewhere on the board
/TXD2_5V: Q5.3 (D), R43.2; also elsewhere on the board
/USB+: U12.5 (UD+); also elsewhere on the board
/USB-: U12.6 (UD-); also elsewhere on the board
GND: C20.2, C30.2, C32.2, C33.2, C34.2, C35.2, C36.2, C41.2, C42.2, C54.2, C55.2, C58.2, C59.2, C60.2, C61.2, C62.2, C64.2, C65.2, C66.2, C67.2, C68.2, D11.2 (A2), D16.2 (A), D22.3, R6.2, R11.2, R19.1, R70.2, SW1.1, U10.2 (GND), U12.1 (GND), U13.1 (GND), U13.15 (GND), U13.38 (GND); also elsewhere on the board
unnamed: C41.1, R20.2
unnamed: C42.1, R21.2
unnamed: R19.2, U10.8 (S)
unnamed: R71.2, U10.4 (RXD)

Notes on the sheet:
UART 3.3V to 5V Logic Converter
USB to UART
Voltage divider for 12V monitor
Speed sensor
NOTES: - The ESP32 will not flash if it'll be in the followed conditions IO1 (HIGH or LOW), IO2 (HIGH), IO3 (HIGH or LOW), IO12 (HIGH). - The ESP32 will not show debug messages via serial on starting if the IO15 will be down (condition that happens because of the pulldown used in the speed sensor).
Embedded CAN
AUTO FLASH

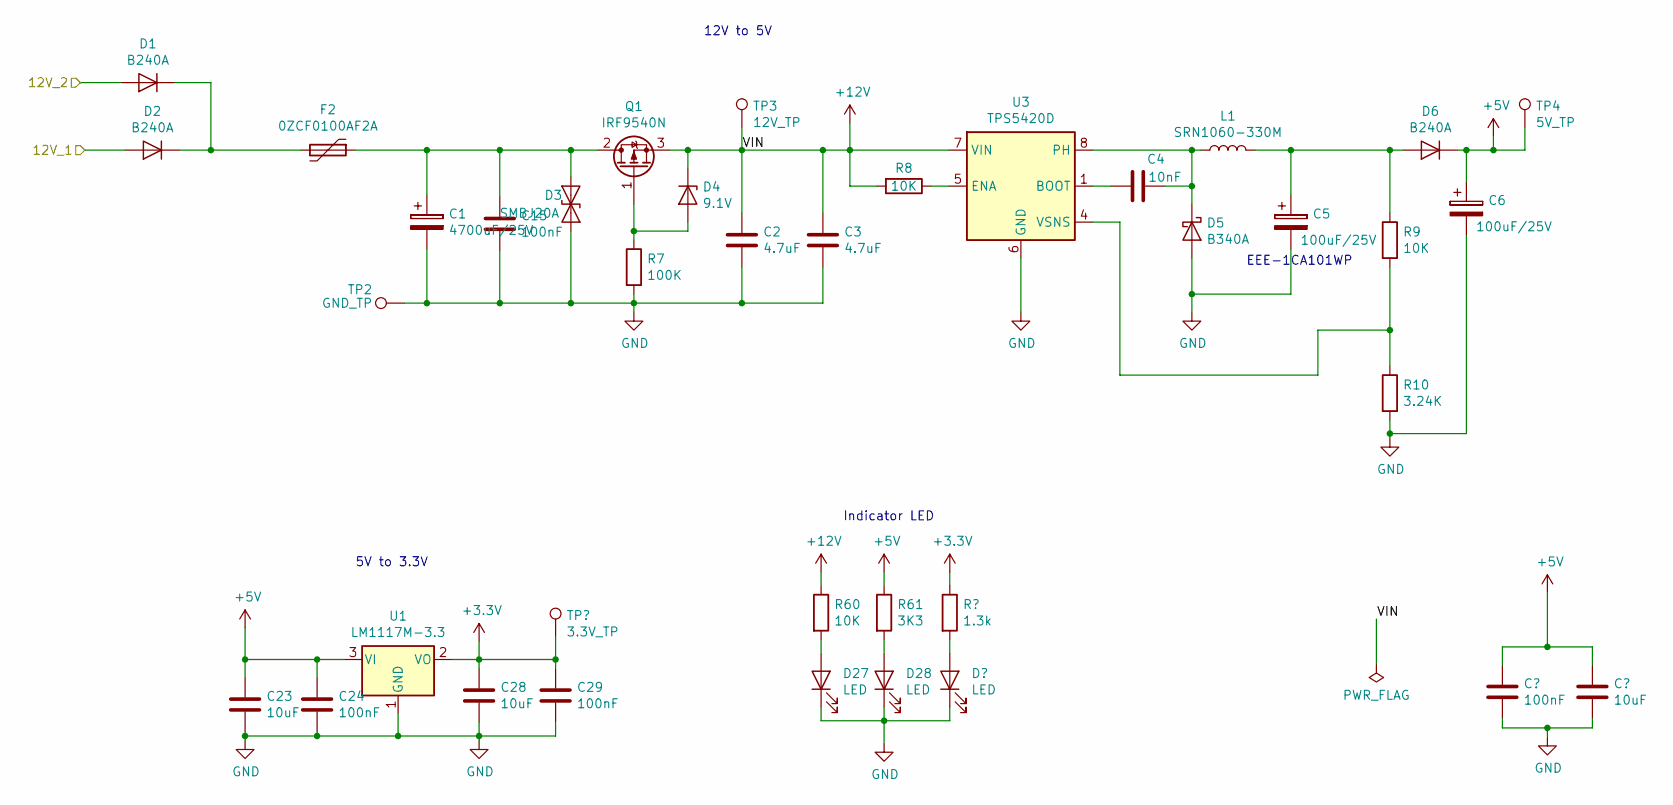
[picture p14: schematic Power Supply.kicad_sch]

Parts:
C1: 4700uF/25V; CP_Radial_D16.0mm_P7.50mm
C2, C3: 4.7uF; C_1206_3216Metric
C4: 10nF; C_0603_1608Metric
C5, C6: 100uF/25V; CP_Elec_6.3x5.8
C7, C15, C24, C29: 100nF; C_0603_1608Metric
C8, C23, C28: 10uF; C_0603_1608Metric
D1, D2, D6: B240A; D_SMA
D3: SMBJ20A; D_SMB
D4: 9.1V; D_SOD-123
D5: B340A; D_SMA
D17, D27, D28: LED; LED_0603_1608Metric
F2: 0ZCF0100AF2A; Fuse_2920_7451Metric
L1: SRN1060-330M; L_Bourns-SRN1060
Q1: IRF9540N; TO-220-3_Horizontal_TabDown
R4: 1.3k; R_0603_1608Metric
R7: 100K; R_0603_1608Metric
R8, R9, R60: 10K; R_0603_1608Metric
R10: 3.24K; R_0603_1608Metric
R61: 3K3; R_0603_1608Metric
TP1: 3.3V_TP; TestPoint_Pad_D1.0mm
TP2: GND_TP; TestPoint_Pad_D1.0mm
TP3: 12V_TP; TestPoint_Pad_D1.0mm
TP4: 5V_TP; TestPoint_Pad_D1.0mm
U1: LM1117M-3.3; SOT-223-3_TabPin2
U3: TPS5420D; SOIC-8_3.9x4.9mm_P1.27mm

Connections:
+3V3: C28.1, C29.1, R4.1, TP1.1, U1.2 (VO); also elsewhere on the board
+5V: C6.1, C7.1, C8.1, C23.1, C24.1, D6.1 (K), R61.1, TP4.1, U1.3 (VI); also elsewhere on the board
+12V: C2.1, C3.1, D4.1 (K), Q1.3 (S), R8.2, R60.1, TP3.1, U3.7 (VIN); also elsewhere on the board
/12V_IN: D2.2 (A); also elsewhere on the board
/CH12V: D1.2 (A); also elsewhere on the board
GND: C1.2, C2.2, C3.2, C5.2, C6.2, C7.2, C8.2, C15.2, C23.2, C24.2, C28.2, C29.2, D3.2 (A2), D5.2 (A), D17.1 (K), D27.1 (K), D28.1 (K), R7.2, R10.2, TP2.1, U1.1 (GND), U3.6 (GND); also elsewhere on the board
unnamed: C1.1, C15.1, D3.1 (A1), F2.1, Q1.2 (D)
unnamed: C4.1, D5.1 (K), L1.1, U3.8 (PH)
unnamed: C4.2, U3.1 (BOOT)
unnamed: C5.1, D6.2 (A), L1.2, R9.1
unnamed: D1.1 (K), D2.1 (K), F2.2
unnamed: D4.2 (A), Q1.1 (G), R7.1
unnamed: D17.2 (A), R4.2
unnamed: D27.2 (A), R60.2
unnamed: D28.2 (A), R61.2
unnamed: R8.1, U3.5 (ENA)
unnamed: R9.2, R10.1, U3.4 (VSNS)

Notes on the sheet:
12V to 5V
EEE-1CA101WP
Indicator LED
5V to 3.3V

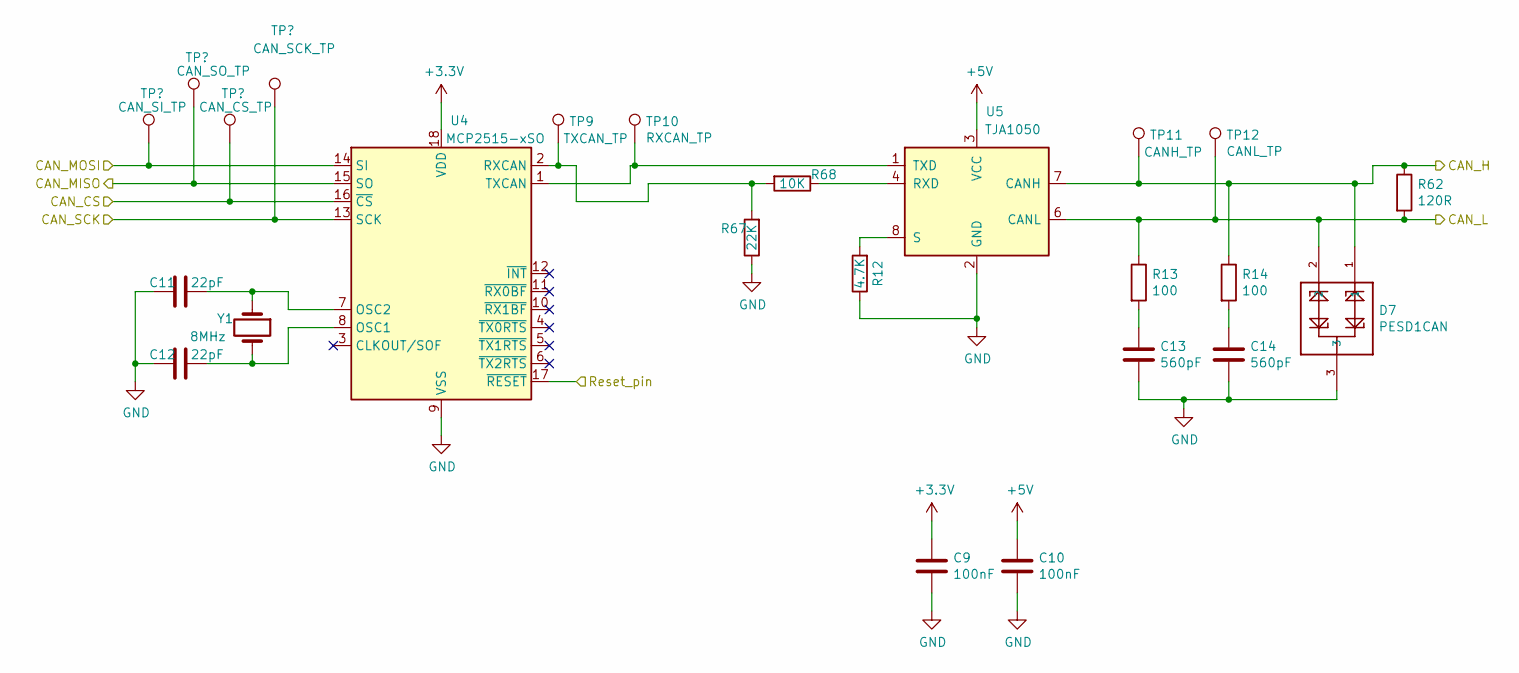
[picture p15: schematic CAN CONTROLLER.kicad_sch]

Parts:
C9, C10: 100nF; C_0603_1608Metric
C11, C12: 22pF; C_0603_1608Metric
C13, C14: 560pF; C_0603_1608Metric
D7: PESD1CAN; SOT-23
R12: 4.7K; R_0603_1608Metric
R13, R14: 100; R_0603_1608Metric
R62: 120R; R_1206_3216Metric
R67: 22K; R_0603_1608Metric
R68: 10K; R_0603_1608Metric
TP5: CAN_SI_TP; TestPoint_Pad_D1.0mm
TP6: CAN_SO_TP; TestPoint_Pad_D1.0mm
TP7: CAN_CS_TP; TestPoint_Pad_D1.0mm
TP8: CAN_SCK_TP; TestPoint_Pad_D1.0mm
TP9: TXCAN_TP; TestPoint_Pad_D1.0mm
TP10: RXCAN_TP; TestPoint_Pad_D1.0mm
TP11: CANH_TP; TestPoint_Pad_D1.0mm
TP12: CANL_TP; TestPoint_Pad_D1.0mm
U4: MCP2515-xSO; SOIC-18W_7.5x11.6mm_P1.27mm
U5: TJA1050; SOIC-8_3.9x4.9mm_P1.27mm
Y1: 8MHz; Crystal_SMD_5032-2Pin_5.0x3.2mm

Connections:
+3V3: C9.1, U4.18 (VDD); also elsewhere on the board
+5V: C10.1, U5.3 (VCC); also elsewhere on the board
/CAN1_H: D7.1, R14.1, R62.1, TP11.1, U5.7 (CANH); also elsewhere on the board
/CAN1_L: D7.2, R13.1, R62.2, TP12.1, U5.6 (CANL); also elsewhere on the board
/CAN CONTROLLER/CAN_CS: TP7.1, U4.16 (~CS); also elsewhere on the board
/CAN CONTROLLER/CAN_MISO: TP6.1, U4.15 (SO); also elsewhere on the board
/CAN CONTROLLER/CAN_MOSI: TP5.1, U4.14 (SI); also elsewhere on the board
/CAN CONTROLLER/CAN_SCK: TP8.1, U4.13 (SCK); also elsewhere on the board
/IC_RESET: U4.17 (~RESET); also elsewhere on the board
GND: C9.2, C10.2, C11.2, C12.2, C13.2, C14.2, D7.3, R12.1, R67.1, U4.9 (VSS), U5.2 (GND); also elsewhere on the board
unnamed: C11.1, U4.7 (OSC2), Y1.1
unnamed: C12.1, U4.8 (OSC1), Y1.2
unnamed: C13.1, R13.2
unnamed: C14.1, R14.2
unnamed: R12.2, U5.8 (S)
unnamed: R67.2, R68.2, TP9.1, U4.2 (RXCAN)
unnamed: R68.1, U5.4 (RXD)
unnamed: TP10.1, U4.1 (TXCAN), U5.1 (TXD)

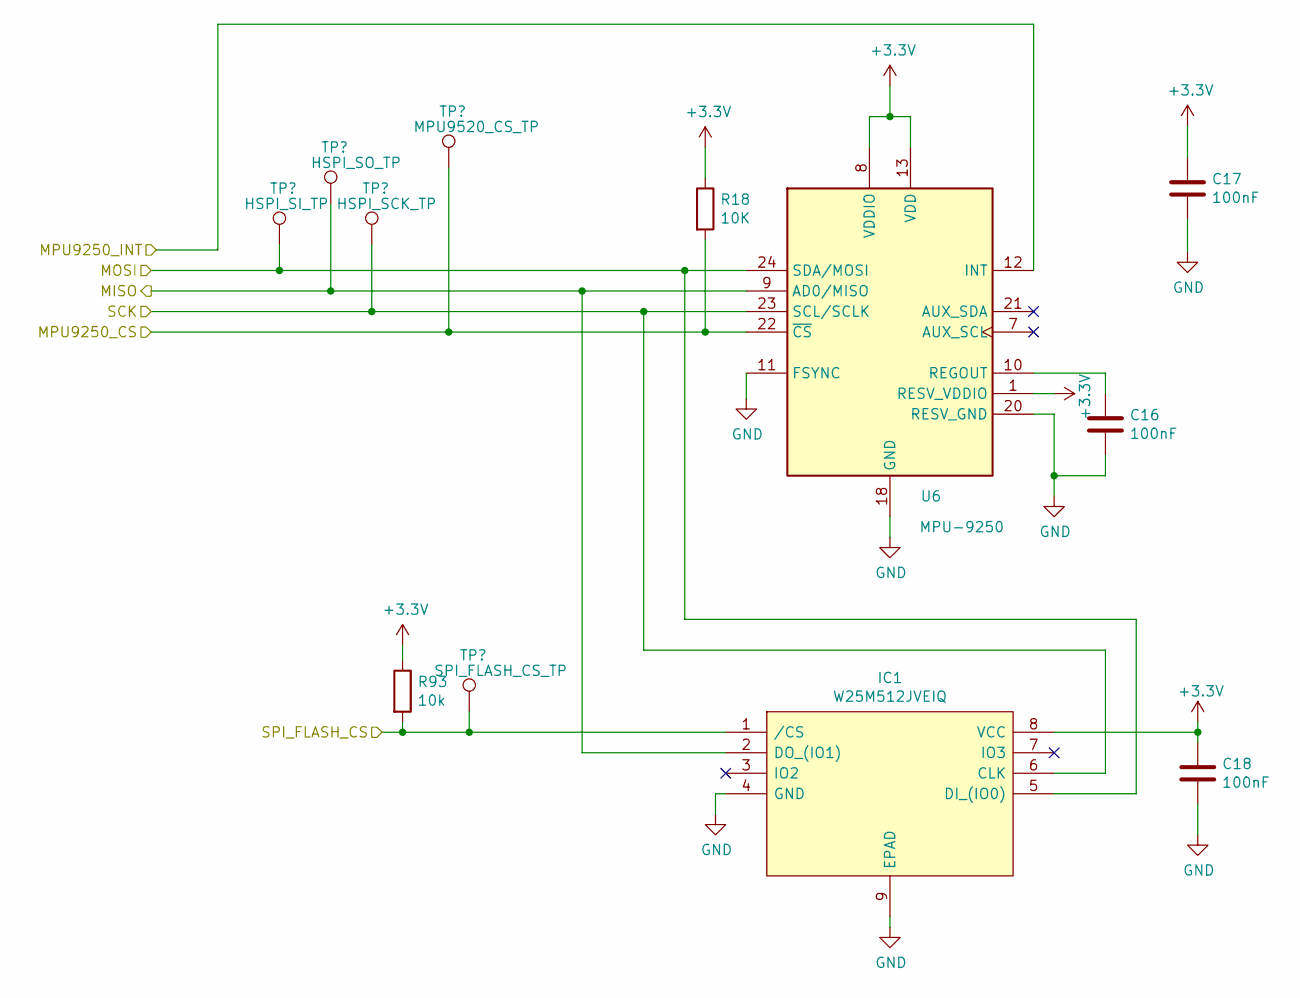
[picture p16: schematic SPIFLASH_MPU9250.kicad_sch]

Parts:
C16, C17, C18: 100nF; C_0603_1608Metric
IC1: W25M512JVEIQ; SON127P800X600X80-9N-D; Manufacturer_Part_Number W25M512JVEIQ; Mouser Part Number 454-W25M512JVEIQ
R18: 10K; R_0603_1608Metric
R93: 10k; R_0603_1608Metric
TP13: HSPI_SI_TP; TestPoint_Pad_D1.0mm
TP14: HSPI_SO_TP; TestPoint_Pad_D1.0mm
TP15: HSPI_SCK_TP; TestPoint_Pad_D1.0mm
TP16: MPU9520_CS_TP; TestPoint_Pad_D1.0mm
TP17: SPI_FLASH_CS_TP; TestPoint_Pad_D1.0mm
U6: MPU-9250; QFN-24-1EP_3x3mm_P0.4mm_EP1.75x1.6mm

Connections:
+3V3: C17.1, C18.1, IC1.8 (VCC), R18.1, R93.1, U6.1 (RESV_VDDIO), U6.8 (VDDIO), U6.13 (VDD); also elsewhere on the board
/ESP32/HSPI_CLK: IC1.6 (CLK), TP15.1, U6.23 (SCL/SCLK); also elsewhere on the board
/ESP32/HSPI_CS1: R18.2, TP16.1, U6.22 (~CS); also elsewhere on the board
/ESP32/HSPI_CS2: IC1.1 (/CS), R93.2, TP17.1; also elsewhere on the board
/ESP32/HSPI_MISO: IC1.2 (DO_(IO1)), TP14.1, U6.9 (AD0/MISO); also elsewhere on the board
/ESP32/HSPI_MOSI: IC1.5 (DI_(IO0)), TP13.1, U6.24 (SDA/MOSI); also elsewhere on the board
/ESP32/MPU9250_INT: U6.12 (INT); also elsewhere on the board
GND: C16.2, C17.2, C18.2, IC1.4 (GND), IC1.9 (EPAD), U6.11 (FSYNC), U6.18 (GND), U6.20 (RESV_GND); also elsewhere on the board
unnamed: C16.1, U6.10 (REGOUT)
