Eric-2012/ESP32-CAN/PCB/ESP32-CAN/ESP32-CAN.kicad_pcb

## KiCad design PCB/ESP32-CAN/ESP32-CAN.kicad_pcb (continued)

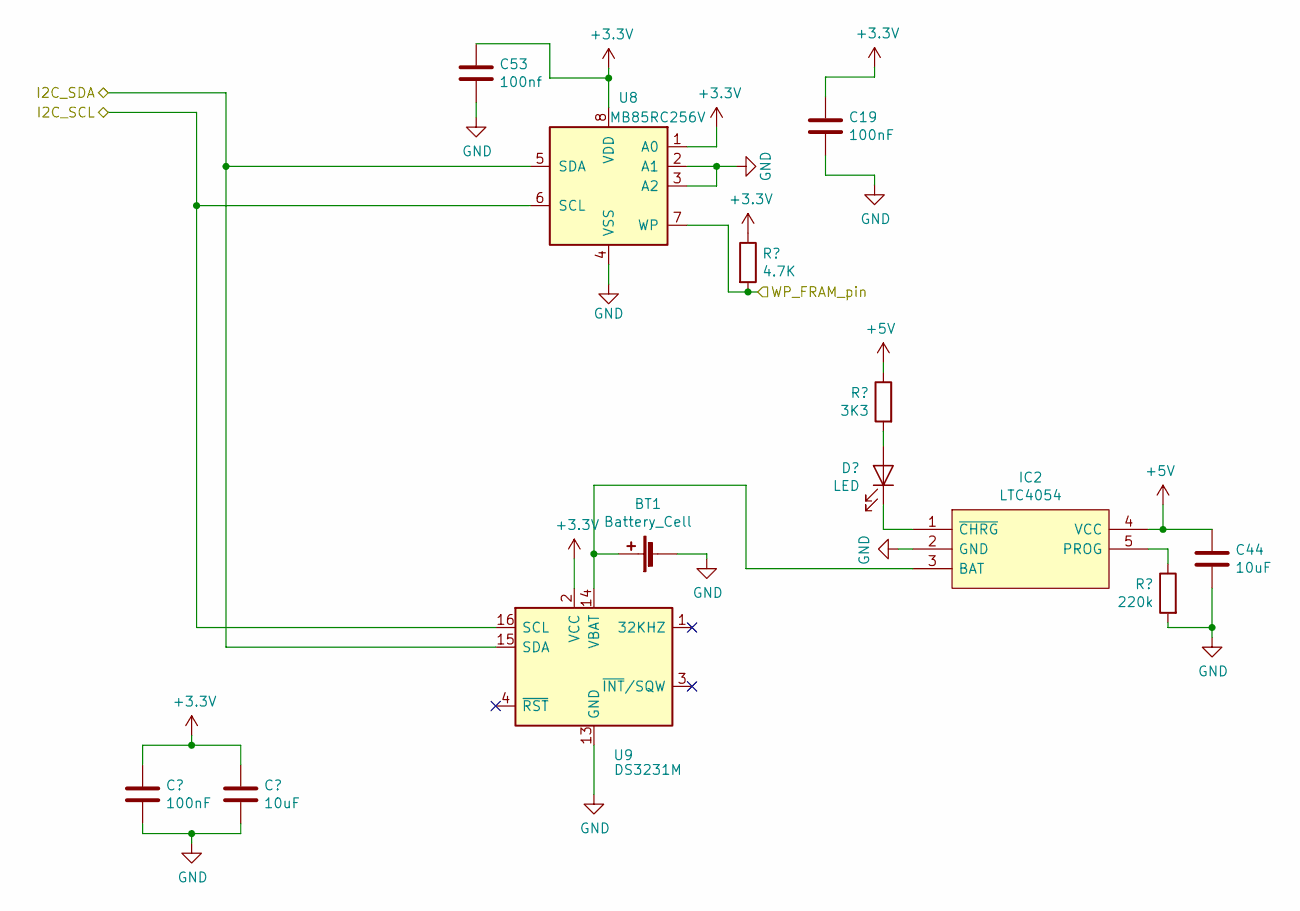
[picture p17: schematic FRAM_EEPROM.kicad_sch]

Parts:
BT1: Battery_Cell; BatteryHolder_Keystone_3034_1x20mm
C19, C21: 100nF; C_0603_1608Metric
C22, C44: 10uF; C_0603_1608Metric
C53: 100nf; C_0603_1608Metric
D30: LED; LED_0603_1608Metric
IC2: LTC4054; SOT-23-5; Manufacturer_Part_Number TP4054-42-SOT25-R
R3: 4.7K; R_0603_1608Metric
R65: 3K3; R_0603_1608Metric
R66: 220k; R_0603_1608Metric
U8: MB85RC256V; SOIC-8_3.9x4.9mm_P1.27mm
U9: DS3231M; SOIC-16W_7.5x10.3mm_P1.27mm

Connections:
+3V3: C19.1, C21.1, C22.1, C53.1, R3.1, U8.1 (A0), U8.8 (VDD), U9.2 (VCC); also elsewhere on the board
+5V: C44.1, IC2.4 (VCC), R65.1; also elsewhere on the board
/ESP32/I2C_SCL: U8.6 (SCL), U9.16 (SCL); also elsewhere on the board
/ESP32/I2C_SDA: U8.5 (SDA), U9.15 (SDA); also elsewhere on the board
/ESP32/WP_FRAM_pin: R3.2, U8.7 (WP); also elsewhere on the board
GND: BT1.2 (-), C19.2, C21.2, C22.2, C44.2, C53.2, IC2.2 (GND), R66.2, U8.2 (A1), U8.3 (A2), U8.4 (VSS), U9.5 (GND), U9.6 (GND), U9.7 (GND), U9.8 (GND), U9.9 (GND), U9.10 (GND), U9.11 (GND), U9.12 (GND), U9.13 (GND); also elsewhere on the board
unnamed: BT1.1 (+), IC2.3 (BAT), U9.14 (VBAT)
unnamed: D30.1 (K), IC2.1 (~CHRG)
unnamed: D30.2 (A), R65.2
unnamed: IC2.5 (PROG), R66.1

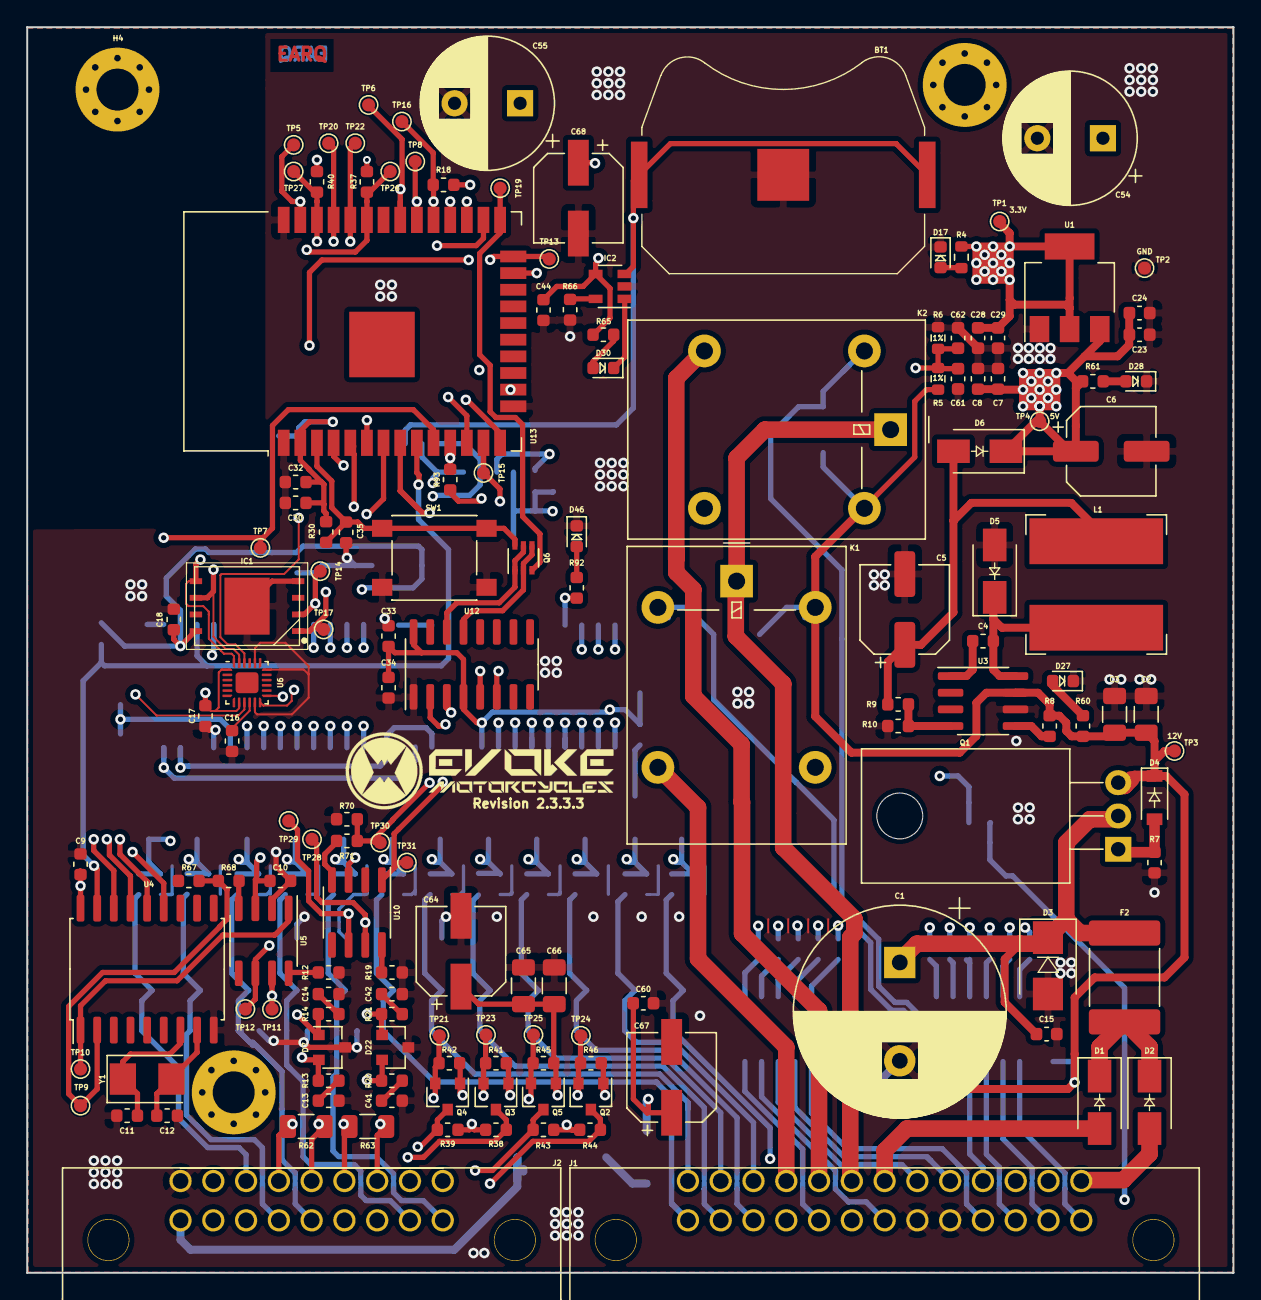
[picture p18: board ESP32-CAN.kicad_pcb from above]

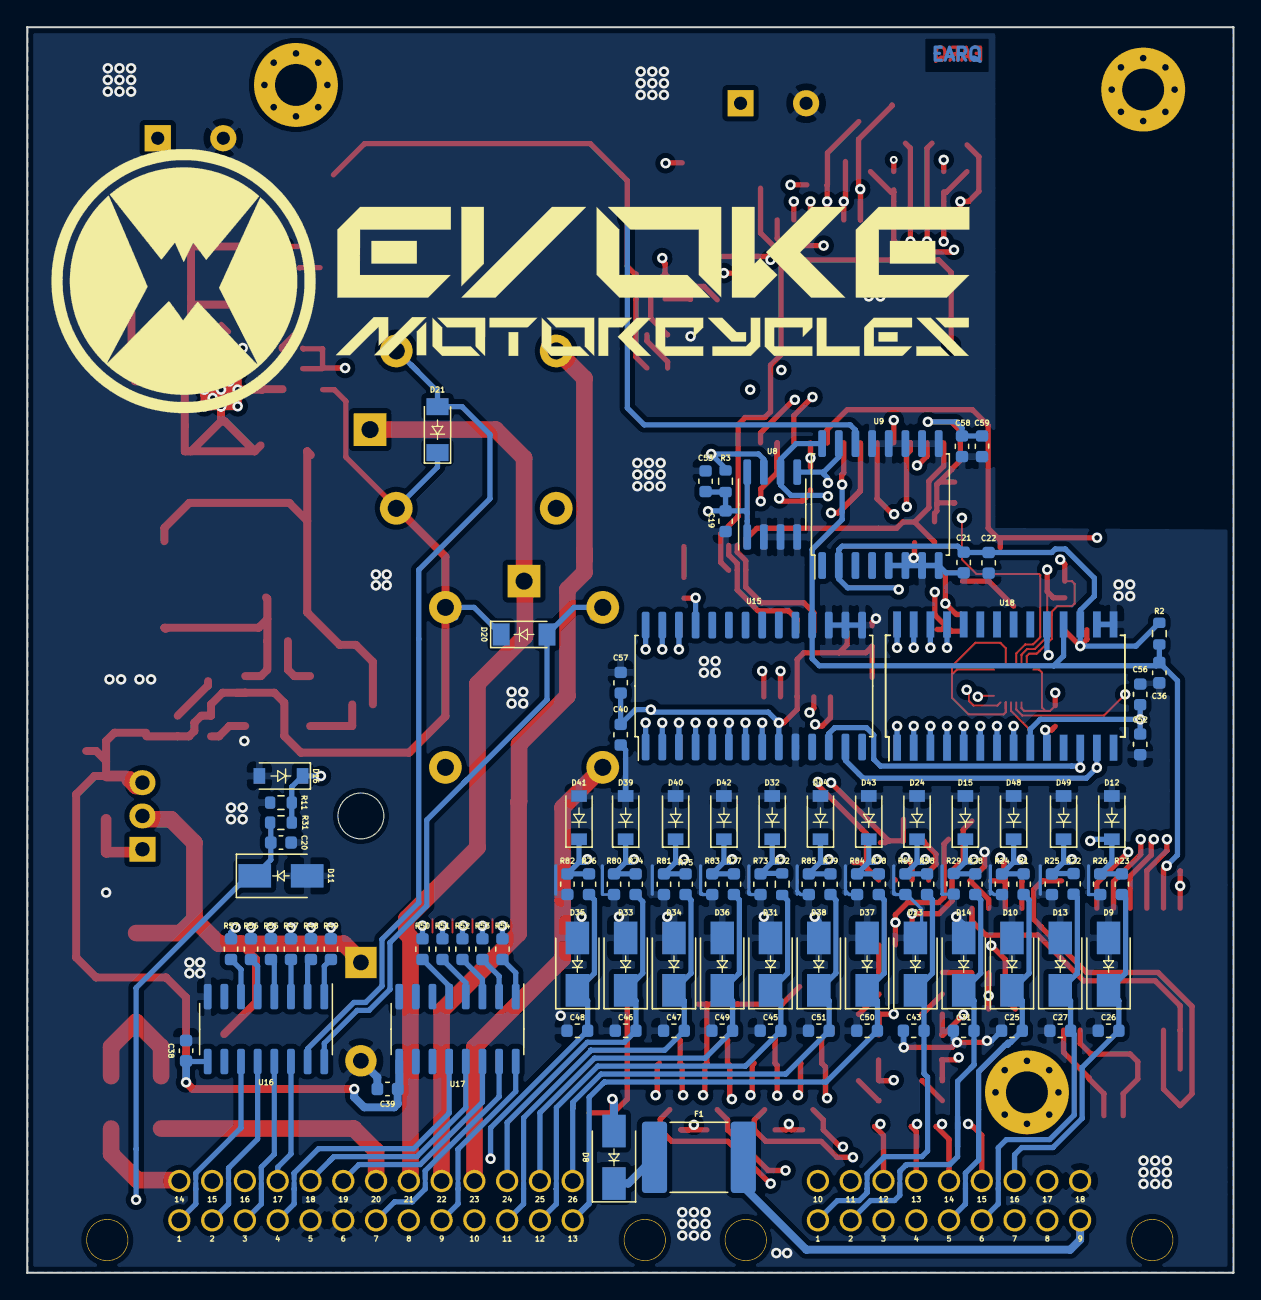
[picture p19: board ESP32-CAN.kicad_pcb from below]

Board: 4 copper layers, 92.0 x 95.0 mm, 249 parts (101 on the bottom side), 138 nets.
