Eric-2012/ESP32-CAN/Code/include/task_Errors.h

/******************************************************************************
 * task_Errors.h
 * Header for task_Errors.cpp
 *****************************************************************************/
#ifndef __TASK_ERRORS_H__
#define __TASK_ERRORS_H__

#include <Arduino.h>

#include "global_Constants.h"
#include "global_Variables.h"
#include "func_Errors.h"

// Code for the task Errors
void taskCode_Errors(void *pvParameters);

#endif
