Eric-2012/ESP32-CAN/Code/include/task_ModeSelector.h

/******************************************************************************
 * task_ModeSelector.h
 * Header for task_ModeSelector.cpp
 *****************************************************************************/
#ifndef __TASK_MODESELECTOR_H__
#define __TASK_MODESELECTOR_H__

#include <Arduino.h>

#include "global_Constants.h"
#include "global_Variables.h"
#include "func_Errors.h"

void taskCode_ModeSelector(void *pvParameters);

#endif
